Yogranov/ble-gate-opener/hardware/case/print/body-and-logo.3mf

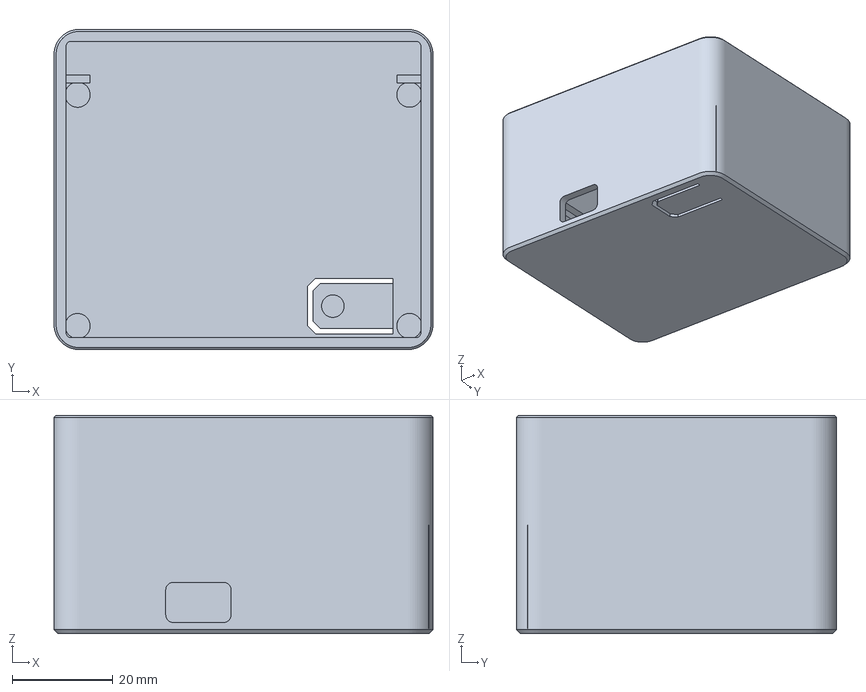
[picture p2: CAD file, 2026-11-06]
hardware/case/print/body-and-logo.3mf
75.4 x 63.7 x 43.4 mm
