Yogranov/ble-gate-opener/hardware/case/print/cover.3mf

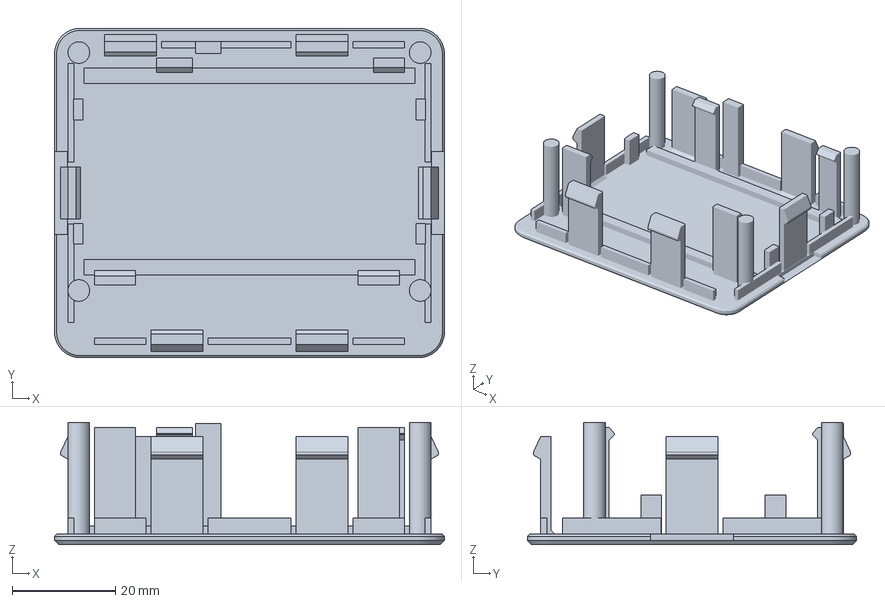
[picture p3: CAD file, 2026-11-06]
hardware/case/print/cover.3mf
75.4 x 63.7 x 23.6 mm
