Yogranov/ble-gate-opener/manual.html

Side 1 of 2. Print at actual size (100%), on both sides, flipping on the long edge. Cut on the four corner marks. Then fold the bottom half behind, twice, and the right half behind, once. The logo stays on the outside, and the sheet ends up 60 × 33 mm.

This bar must measure 50 mm, or the folded sheet will not fit the case:

YogiGate

# Technician manual

Fit a unit in a car, pair it with the gate's beacon, and test it.

## Set it up

1. Fit the unit. Stick the case in the glove box with Velcro. Any position works, but it must not slide or tumble.
2. Power it. Use a phone charger in a socket that turns off with the ignition, not a screen's USB port, and start the car. One long beep means no beacon is paired yet.
3. Start the hotspot. Triple-click the button on top of the case. You hear three short beeps. It does not start by itself.
4. Join it. In your phone's Wi-Fi settings, choose YogiGate-XXXX. The password is password. If the phone warns about no internet, stay connected.
5. Open the page. Go to http://192.168.4.1, and type the http:// too.
6. Pair the beacon. On the Beacon tab, either type its MAC, or tap Scan and then Use. At the bench, you can also hold the button for 3 s and hold the beacon against the unit. You hear short, short, long.
1. Test it, parked. On the Status tab, Signal shows a number and Live motion moves when you shake the unit. Close the glove box and tap Press the remote. You hear one short beep, and the gate must open from the parking spot.
2. Test it, driving. Start the car and wait: the gate must stay shut. Drive off: the gate opens within a few seconds, with no beep.

## The button

One clickPress the remote

Two clicksSet the set point here

Three clicksStart the hotspot

Hold 3 sPair a beacon held close

Hold 15 sFactory reset

Two clicks, then hold 6 sLearn the gate remote (RF units)

Factory reset erases the settings, beacon and logs, and puts the password back to password. With the unit on, hold the button past the two short beeps, until you hear five short and one long. One long beep means it is done, within a minute.

## Good to know

Replace the remote's battery every year, because the unit cannot tell when it dies. Advanced mode, at the bottom of the Settings tab, shows every setting, Reset to defaults, Factory reset and firmware upload. Change password is on the same tab. This manual is also on the page's Help tab.

Side 2 of 2. This is the back of the same sheet. It goes back inside the case folded, taped to the inside of the top, in the middle.

## What each sound means

No beep when the gate opens by itself. That is correct.

One short: pressed by hand

Two short: pairing, so hold the beacon close

Three short: hotspot starting

Short, short, long: saved

Two rattles: that did not work, so try again

One long at power-on: no beacon is paired yet

Three long: motion sensor failed

Five short, one long: factory reset, erasing

## If it goes wrong

No hotspotTriple-click, and listen for three short beeps.

Page will not openJoin by hand in Wi-Fi settings, and type http://.

Gate stays shutCheck the remote's battery and range, then the Signal on the Status tab.

Opens from the streetRaise the set point on the Settings tab.

Opens while parkedFix the unit so it cannot move, then rate that trip on the Logs tab.

Three long beepsCheck the sensor's four wires. Until fixed, the gate can open from the spot.

Remote's LED stays onIts two wires are swapped.

## Keep this sheet

Fold the bottom half behind, twice, and the right half behind, once, with the logo outside. Tape it to the inside of the case's top, in the middle, with its long side along the case's long side. Keep it off the button tab.
