Yogranov/ble-gate-opener/tools/yg_logs.py

#!/usr/bin/env python3
"""Fetch and analyse YogiGate logs. Log files stay in logs/, which git ignores.

    python tools/yg_logs.py fetch --port COM3          over USB
    python tools/yg_logs.py fetch --host 192.168.4.1   over the hotspot
    python tools/yg_logs.py summary logs/some.ndjson   one line per trip, then totals
    python tools/yg_logs.py replay logs/some.ndjson --trip 12 --set motion_accel_mg=60

Replay runs a trip through the current logic, starting from the settings the trip
really had, then changed by any --set. Build it first with: python test/host/run_tests.py
"""
import argparse
import base64
import json
import os
import statistics
import struct
import subprocess
import sys
import time
import urllib.request

ROOT = os.path.abspath(os.path.join(os.path.dirname(__file__), ".."))
ACCEL_LSB_PER_G = 16384.0
GYRO_LSB_PER_DPS = 131.0
SAMPLE_MS = 20
TICK_MS = 100
# What a boot record calls the settings that decide on a press, and what they are called.
BOOT_SETTINGS = {
    "set_point": "set_point_dbm", "press_ms": "press_ms", "moved_window_s": "moved_window_s", "gone_s": "gone_s",
    "still_s": "still_s", "fallback_dbm": "fallback_dbm", "motion_enabled": "motion_enabled",
    "motion_accel_mg": "motion_accel_mg", "motion_accel_ms": "motion_accel_ms", "motion_yaw_deg": "motion_yaw_deg",
    "motion_yaw_window_ms": "motion_yaw_window_ms",
}
# The esp_reset_reason_t values worth mentioning. See docs/log-format.md.
BAD_RESETS = {4: "panic", 5: "watchdog", 6: "watchdog", 7: "watchdog", 9: "brownout"}
BROWNOUT = 9


def default_output():
    os.makedirs(os.path.join(ROOT, "logs"), exist_ok=True)
    return os.path.join(ROOT, "logs", time.strftime("yogigate-%Y%m%d-%H%M%S.ndjson"))


def fetch_usb(port, captures, out_path):
    sys.path.insert(0, os.path.dirname(__file__))
    import yg_serial

    s = yg_serial.open_port(port)
    s.reset_input_buffer()
    s.write(("logs" if captures else "logs nocapture").encode() + b"\n")
    good = bad = 0
    data = bytearray()
    last = time.time()
    done = False
    with open(out_path, "w", encoding="utf-8") as out:
        begun = False
        while time.time() - last < 15 and not done:
            chunk = s.read(65536)
            if not chunk:
                continue
            last = time.time()
            data += chunk
            *lines, rest = data.split(b"\n")
            data = bytearray(rest)
            for raw in lines:
                line = raw.decode(errors="replace").strip()
                if line == "#BEGIN":
                    begun = True
                elif line == "#END":
                    done = True
                elif begun and line.startswith("{"):
                    try:
                        json.loads(line)
                        out.write(line + "\n")
                        good += 1
                    except ValueError:
                        bad += 1
    s.close()
    print(f"{good} records saved to {out_path}" + (f", {bad} damaged lines skipped" if bad else ""))
    if not done:
        print("WARNING: the unit stopped sending before the end of the logs. This file is not complete.")


def fetch_http(host, captures, out_path):
    url = f"http://{host}/api/logs/export" + ("" if captures else "?captures=0")
    with urllib.request.urlopen(url, timeout=120) as response, open(out_path, "wb") as out:
        total = 0
        while True:
            chunk = response.read(65536)
            if not chunk:
                break
            out.write(chunk)
            total += len(chunk)
    print(f"{total} bytes saved to {out_path}")


def read_records(path):
    with open(path, encoding="utf-8") as f:
        for line in f:
            line = line.strip()
            if line:
                try:
                    yield json.loads(line)
                except ValueError:
                    pass


def trace_samples(record):
    """Yields (time_ms, rssi or None, adverts, accel_mg, yaw_dps, flags)."""
    for i, s in enumerate(record["s"]):
        yield record["t"] + i * record["period"] * 1000, s[0] if s[1] else None, s[1], s[2], s[3], s[4]


def summarise(records):
    trips = {}
    ratings = {}

    def trip_of(number):
        return trips.setdefault(number, {
            "trip": number, "fw": "", "duration": 0, "heard": None, "motion": None, "press": None, "presses": 0,
            "parked": None, "peak": None, "heard_adverts": 0, "heard_seconds": 0, "temp": None, "errors": [], "env": None, "near_miss": 0,
            "reset": None, "zero": None,
        })

    for r in records:
        if "trip" not in r:
            continue
        t = trip_of(r["trip"])
        kind = r.get("k")
        t["duration"] = max(t["duration"], r["t"])
        if kind == "boot":
            t["fw"] = r["fw"]
            t["reset"] = r.get("reset")
        elif kind == "gyro_zero" and t["zero"] is None:
            t["zero"] = r
        elif kind == "first_heard" and t["heard"] is None:
            t["heard"] = r
        elif kind == "motion" and t["motion"] is None:
            t["motion"] = r
        elif kind == "press":
            t["presses"] += 1
            if t["press"] is None:
                t["press"] = r
        elif kind == "temp" and t["temp"] is None:
            t["temp"] = r["c"]
        elif kind == "error":
            t["errors"].append(r["code"])
        elif kind == "env":
            t["env"] = r
        elif kind == "rating":
            ratings[r["rated_trip"]] = r["rating"]
        elif kind == "trace":
            for at, rssi, adverts, _, _, flags in trace_samples(r):
                t["duration"] = max(t["duration"], at)
                # Longer periods cap their count and may only be heard for part of the time.
                if r["period"] == 1 and adverts:
                    t["heard_adverts"] += adverts
                    t["heard_seconds"] += 1
                if flags & 2:
                    t["near_miss"] += 1
                if rssi is None:
                    continue
                if t["peak"] is None or rssi > t["peak"][1]:
                    t["peak"] = (at, rssi)
    for r in records:
        # A second pass, because trace records can reach the log after a motion record.
        if r.get("k") == "trace":
            t = trips[r["trip"]]
            for at, rssi, *_ in trace_samples(r):
                if rssi is not None and (t["motion"] is None or at < t["motion"]["t"]):
                    t["parked"] = rssi if t["parked"] is None else max(t["parked"], rssi)
    for number, rating in ratings.items():
        trip_of(number)["rating"] = rating
    return trips


def restart_note(t, failed):
    """Why this trip's start was not a clean one. A start that dies before the radio is up
    uses a trip number and logs nothing, so only the gap and the next start's reset show it."""
    name = BAD_RESETS.get(t["reset"])
    if name is None:
        return ""
    return f"{name} after {failed} failed start{'' if failed == 1 else 's'}" if failed else name


def cmd_summary(args):
    records = list(read_records(args.file))
    trips = summarise(records)
    print(f"{'trip':>5} {'fw':>7} {'length':>7} {'parked':>7} {'moved':>7} {'press':>7} {'n':>2} {'reason':>8} "
          f"{'warn':>6} {'peak':>5} {'adv/s':>6} {'temp':>5} {'near':>4}  rating / errors")
    warnings, parked, peaks = [], [], []
    failed_total = failed_chains = 0
    previous = None
    for number in sorted(trips):
        t = trips[number]
        failed = number - previous - 1 if previous is not None and t["reset"] == BROWNOUT else 0
        previous = number
        failed_total += failed
        failed_chains += 1 if failed else 0
        seconds = t["duration"] / 1000
        press_at = f"{t['press']['t'] / 1000:.1f}" if t["press"] else "-"
        moved_at = f"{t['motion']['t'] / 1000:.1f}" if t["motion"] else "-"
        warn = "-"
        if t["press"] and t["peak"] and t["peak"][0] >= t["press"]["t"]:
            value = (t["peak"][0] - t["press"]["t"]) / 1000
            warnings.append(value)
            warn = f"{value:.1f}"
        if t["parked"] is not None:
            parked.append(t["parked"])
        if t["peak"]:
            peaks.append(t["peak"][1])
        guessed = t["zero"] is not None and t["zero"]["how"] == "time_up"
        note = " ".join(filter(None, [restart_note(t, failed), "gyro zero guessed" if guessed else "", t.get("rating"), ",".join(t["errors"])]))
        adverts = f"{t['heard_adverts'] / t['heard_seconds']:.1f}" if t["heard_seconds"] else "-"
        print(f"{number:>5} {t['fw']:>7} {seconds:>6.0f}s {t['parked'] if t['parked'] is not None else '-':>7} "
              f"{moved_at:>7} {press_at:>7} {t['presses']:>2} {t['press']['reason'] if t['press'] else '-':>8} "
              f"{warn:>6} {t['peak'][1] if t['peak'] else '-':>5} {adverts:>6} "
              f"{t['temp'] if t['temp'] is not None else '-':>5} {t['near_miss']:>4}  {note}")
    print()
    pressed_parked = sum(1 for t in trips.values() if t["press"] and t["press"]["reason"] == "auto" and t["motion"] is None)
    print(f"{len(trips)} trips, {sum(t['presses'] for t in trips.values())} presses, "
          f"{sum(1 for t in trips.values() if t['errors'])} with errors, "
          f"{pressed_parked} automatic presses with no motion logged.")
    if failed_total:
        print(f"{failed_total} failed start{'' if failed_total == 1 else 's'} before "
              f"{failed_chains} power-up{'' if failed_chains == 1 else 's'}. Time is lost to each, and the gate cannot open meanwhile.")
    if warnings:
        print(f"Warning time: median {statistics.median(warnings):.1f} s, range {min(warnings):.1f} to {max(warnings):.1f} s.")
    if parked:
        print(f"Strongest signal while parked: median {statistics.median(parked):.0f}, range {min(parked)} to {max(parked)} dBm.")
    if peaks:
        print(f"Peak signal: median {statistics.median(peaks):.0f}, range {min(peaks)} to {max(peaks)} dBm.")
    captures = sum(1 for r in records if r.get("k") == "cap_start")
    if captures:
        print(f"{captures} debug captures.")


def capture_events(records, trip):
    """Raw motion samples and adverts from one trip's debug captures, and the spans of
    time they cover. A capture cut short by a power cut still counts: samples are timed
    from its start record."""
    events = []
    windows = []
    start = None
    for r in records:
        if r.get("trip") != trip:
            continue
        kind = r.get("k")
        if kind == "cap_start":
            start = r
            windows.append([r["t"] - r["pre"] * SAMPLE_MS, r["t"]])
        elif kind == "cap_imu" and start is not None:
            data = base64.b64decode(r["b64"])
            for i in range(r["n"]):
                s = struct.unpack_from("<6h", data, i * 12)
                at = start["t"] + (r["first"] + i - start["pre"]) * SAMPLE_MS
                values = [v / ACCEL_LSB_PER_G for v in s[:3]] + [v / GYRO_LSB_PER_DPS for v in s[3:]]
                events.append((at, f"I,{at}," + ",".join(f"{v:.5f}" for v in values)))
                windows[-1][1] = max(windows[-1][1], at)
        elif kind == "cap_adv" and start is not None:
            data = base64.b64decode(r["b64"])
            for i in range(r["n"]):
                at, rssi = struct.unpack_from("<Ib", data, i * 5)
                events.append((at, f"A,{at},{rssi}"))
    return events, windows


def trace_events(records, trip):
    events = []
    for r in records:
        if r.get("trip") != trip:
            continue
        if r.get("k") == "motion":
            events.append((r["t"], f"M,{r['t']}"))
        elif r.get("k") == "trace":
            for at, rssi, *_ in trace_samples(r):
                if rssi is not None:
                    events.append((at, f"A,{at},{rssi}"))
    return events


def boot_settings(records, trip):
    """The settings the trip started with, as (key, value) pairs."""
    for r in records:
        if r.get("trip") == trip and r.get("k") == "boot":
            pairs = []
            for name, key in BOOT_SETTINGS.items():
                if name in r:
                    value = r[name]
                    pairs.append((key, int(value) if isinstance(value, bool) else value))
            return pairs
    return []


def saved_zero(records, trip):
    """The gyro zero the unit had saved when the trip started, as far as its record shows. A
    first steady start saved its own, and a trip that guessed had none it could use."""
    for r in records:
        if r.get("trip") == trip and r.get("k") == "gyro_zero":
            used_saved = r["how"] == "known" or (r["how"] == "steady" and not r["saved"])
            return (r["x"], r["y"], r["z"]) if used_saved else None
    return None


def setting_events(records, trip, overridden):
    """Settings changed during the trip, unless this replay is overriding them."""
    known = set(BOOT_SETTINGS.values()) - overridden
    return [(r["t"], f"set,{r['key']},{r['value']}") for r in records
            if r.get("trip") == trip and r.get("k") == "setting" and r["key"] in known]


def sensor_events(records, trip):
    events = []
    for r in records:
        if r.get("trip") == trip and r.get("k") == "error" and r["code"].startswith("sensor_") and r["code"] != "sensor_glitch":
            events.append((r["t"], f"{'R' if r['code'] == 'sensor_recovered' else 'F'},{r['t']}"))
    return events


def cmd_replay(args):
    exe = os.path.join(ROOT, "build-host", "replay" + (".exe" if os.name == "nt" else ""))
    if not os.path.exists(exe):
        sys.exit("Build the replay program first: python test/host/run_tests.py")
    records = list(read_records(args.file))
    overrides = [change.partition("=")[::2] for change in args.settings]
    captured, windows = capture_events(records, args.trip)
    # Raw data is better where there is any, but only the trace covers the rest.
    traced = [e for e in trace_events(records, args.trip) if not any(a <= e[0] <= b for a, b in windows)]
    events = captured + traced + sensor_events(records, args.trip)
    if not events:
        sys.exit(f"Trip {args.trip} has nothing to replay.")
    events += setting_events(records, args.trip, {key for key, _ in overrides})
    events.sort(key=lambda e: e[0])
    source = f"{len(windows)} raw captures and the trace" if windows else "the trace, with motion as logged"
    start_settings = boot_settings(records, args.trip)
    lines = [f"set,{key},{value}" for key, value in start_settings + overrides]
    zero = saved_zero(records, args.trip)
    if zero is not None:
        lines.append("zero," + ",".join(str(v) for v in zero))
    next_tick = events[0][0]
    for at, line in events:
        while next_tick <= at:
            lines.append(f"T,{next_tick}")
            next_tick += TICK_MS
        lines.append(line)
    for _ in range(600):
        lines.append(f"T,{next_tick}")
        next_tick += TICK_MS
    result = subprocess.run([exe], input="\n".join(lines) + "\n", capture_output=True, text=True)
    if result.returncode != 0:
        sys.exit(result.stderr.strip())
    print(f"Trip {args.trip}, from {source}.")
    print("Recorded:")
    for r in records:
        if r.get("trip") == args.trip and r.get("k") in ("press", "motion", "rearm"):
            print(f"  {r['k'].upper()},{r['t']},{r.get('reason') or r.get('cause')}")
    base = "the trip's settings" if start_settings else "default settings, as its boot record is gone"
    print("Replayed with " + ", then ".join([base] + args.settings) + ":")
    print("  " + (result.stdout.strip().replace("\n", "\n  ") or "nothing"))


def main():
    parser = argparse.ArgumentParser(description=__doc__, formatter_class=argparse.RawDescriptionHelpFormatter)
    sub = parser.add_subparsers(dest="command", required=True)
    fetch = sub.add_parser("fetch")
    fetch.add_argument("--port")
    fetch.add_argument("--host")
    fetch.add_argument("--out")
    fetch.add_argument("--no-captures", action="store_true")
    summary = sub.add_parser("summary")
    summary.add_argument("file")
    replay = sub.add_parser("replay")
    replay.add_argument("file")
    replay.add_argument("--trip", type=int, required=True)
    replay.add_argument("--set", dest="settings", action="append", default=[], metavar="KEY=VALUE")
    args = parser.parse_args()

    if args.command == "fetch":
        out = args.out or default_output()
        if args.port:
            fetch_usb(args.port, not args.no_captures, out)
        elif args.host:
            fetch_http(args.host, not args.no_captures, out)
        else:
            sys.exit("Give --port or --host.")
    elif args.command == "summary":
        cmd_summary(args)
    else:
        cmd_replay(args)


if __name__ == "__main__":
    main()
