Yogranov/ble-gate-opener/test/host/test_motion.c

#include <math.h>
#include <stdlib.h>

#include "yg_motion.h"
#include "yg_test.h"

#define DT_MS 20
#define PI    3.14159265f

/* Attitude maps the car frame (x forward, y left, z up) to the sensor frame. */
typedef struct { float m[3][3]; } mat3;

static mat3 identity(void) {
    mat3 r = { { { 1, 0, 0 }, { 0, 1, 0 }, { 0, 0, 1 } } };
    return r;
}

static mat3 mul(mat3 a, mat3 b) {
    mat3 r;
    for (int i = 0; i < 3; i++) {
        for (int j = 0; j < 3; j++) {
            r.m[i][j] = a.m[i][0] * b.m[0][j] + a.m[i][1] * b.m[1][j] + a.m[i][2] * b.m[2][j];
        }
    }
    return r;
}

static mat3 rot_x(float deg) {
    float c = cosf(deg * PI / 180), s = sinf(deg * PI / 180);
    mat3 r = { { { 1, 0, 0 }, { 0, c, -s }, { 0, s, c } } };
    return r;
}

static mat3 rot_y(float deg) {
    float c = cosf(deg * PI / 180), s = sinf(deg * PI / 180);
    mat3 r = { { { c, 0, s }, { 0, 1, 0 }, { -s, 0, c } } };
    return r;
}

static void apply(const mat3 *r, const float v[3], float out[3]) {
    for (int i = 0; i < 3; i++) {
        out[i] = r->m[i][0] * v[0] + r->m[i][1] * v[1] + r->m[i][2] * v[2];
    }
}

static const float BIAS[3] = { 10.0f, -7.0f, 4.0f };

typedef struct {
    yg_motion_t m;
    yg_settings_t s;
    mat3 attitude;
    uint32_t now;
    yg_motion_cause_t first_cause;
    uint32_t first_cause_at;
    bool any_near_miss;
    yg_motion_out_t out;

    /* What a real sensor adds, in its own axes. */
    float zero[3];                   /* deg/s: the gyro's zero moving after calibration. */
    float accel_offset[3];           /* g */
    float gyro_scale;                /* A fraction. */
    float shake_a, shake_g;          /* Engine shake at 23 Hz, in g and deg/s. */
    float random_a, random_g;        /* Band-limited shake: standard deviations. */
    float random_alpha, random_slow_alpha;
    float random_lp[6], random_slow[6];
    uint32_t tick;
} rig_t;

static float noise(float amp) {
    return amp * ((float)rand() / (float)RAND_MAX * 2.0f - 1.0f);
}

/* One sample: linear acceleration in g and rotation in deg/s, both in the car frame. */
static void step(rig_t *r, const float accel[3], const float gyro[3]) {
    float car_a[3] = { accel[0], accel[1], accel[2] + 1.0f };
    yg_imu_sample_t in;
    float a[3], g[3];
    apply(&r->attitude, car_a, a);
    apply(&r->attitude, gyro, g);
    float phase = 2 * PI * 23.0f * (float)(r->tick++) * 0.02f;
    const float shake_a[3] = { r->shake_a * sinf(phase), r->shake_a * cosf(phase), r->shake_a * sinf(phase + 1) };
    const float shake_g[3] = { r->shake_g * sinf(phase), r->shake_g * cosf(phase), r->shake_g * sinf(phase + 2) };
    float v[6];
    for (int i = 0; i < 3; i++) {
        v[i] = a[i] + r->accel_offset[i] + shake_a[i] + noise(0.002f);
        v[i + 3] = g[i] * (1.0f + r->gyro_scale) + BIAS[i] + r->zero[i] + shake_g[i] + noise(0.1f);
    }
    for (int i = 0; r->random_alpha > 0 && i < 6; i++) {
        float sd = i < 3 ? r->random_a : r->random_g;
        r->random_lp[i] += r->random_alpha * (noise(sd * sqrtf(3.0f * (2.0f - r->random_alpha) / r->random_alpha)) - r->random_lp[i]);
        r->random_slow[i] += r->random_slow_alpha * (r->random_lp[i] - r->random_slow[i]);
        v[i] += r->random_lp[i] - r->random_slow[i];
    }
    in.ax = v[0];
    in.ay = v[1];
    in.az = v[2];
    in.gx = v[3];
    in.gy = v[4];
    in.gz = v[5];
    yg_motion_update(&r->m, &r->s, r->now, &in, &r->out);
    if (r->out.cause != YG_MOTION_NONE && r->first_cause == YG_MOTION_NONE) {
        r->first_cause = r->out.cause;
        r->first_cause_at = r->now;
    }
    if (r->out.near_miss) r->any_near_miss = true;
    r->now += DT_MS;
}

static void still(rig_t *r, uint32_t ms) {
    const float zero[3] = { 0, 0, 0 };
    for (uint32_t t = 0; t < ms; t += DT_MS) step(r, zero, zero);
}

static void rig_init(rig_t *r, mat3 attitude) {
    memset(r, 0, sizeof(*r));
    yg_settings_defaults(&r->s);
    yg_motion_init(&r->m);
    r->attitude = attitude;
    r->now = 1000;
}

static void reset_seen(rig_t *r) {
    r->first_cause = YG_MOTION_NONE;
    r->any_near_miss = false;
}

static mat3 orientation(int i) {
    switch (i) {
    case 0: return identity();
    case 1: return mul(rot_x(35), rot_y(50));
    case 2: return mul(rot_x(170), rot_y(-20));
    default: return rot_y(90);   /* Standing on its side. */
    }
}
#define ORIENTATIONS 4

static void still_car_calibrates_fast_and_stays_quiet(void) {
    for (int o = 0; o < ORIENTATIONS; o++) {
        static rig_t r;
        rig_init(&r, orientation(o));
        still(&r, 2100);
        CHECK(r.out.calibrated);
        still(&r, 60000);
        CHECK_INT(r.first_cause, YG_MOTION_NONE);
    }
}

static void no_motion_is_reported_before_calibration(void) {
    static rig_t r;
    rig_init(&r, identity());
    const float a[3] = { 0.3f, 0, 0 };
    const float g[3] = { 0, 0, 40 };
    for (int i = 0; i < 20; i++) step(&r, a, g);
    CHECK(!r.out.calibrated);
    CHECK_INT(r.first_cause, YG_MOTION_NONE);
}

static void engine_shake_is_ignored_and_calibration_falls_back(void) {
    static rig_t r;
    rig_init(&r, orientation(1));
    uint32_t calibrated_at = 0;
    for (uint32_t t = 0; t < 60000; t += DT_MS) {
        float phase = 2 * PI * 23.0f * (float)t / 1000.0f;
        float a[3] = { 0.03f * sinf(phase), 0.03f * cosf(phase), 0.03f * sinf(phase + 1) };
        float g[3] = { 2.0f * sinf(phase), 2.0f * cosf(phase), 2.0f * sinf(phase + 2) };
        step(&r, a, g);
        if (r.out.calibrated && calibrated_at == 0) calibrated_at = t + DT_MS;
    }
    CHECK(calibrated_at > 0);
    CHECK(calibrated_at <= 10100);
    CHECK_INT(r.first_cause, YG_MOTION_NONE);
}

static void pulling_out_reports_acceleration_within_a_second(void) {
    for (int o = 0; o < ORIENTATIONS; o++) {
        static rig_t r;
        rig_init(&r, orientation(o));
        still(&r, 5000);
        uint32_t start = r.now;
        const float a[3] = { 0.1f, 0, 0 };
        const float g[3] = { 0, 0, 0 };
        for (int i = 0; i < 100; i++) step(&r, a, g);
        CHECK_INT(r.first_cause, YG_MOTION_ACCEL);
        CHECK(r.first_cause_at - start <= 1000);
    }
}

static void reversing_is_detected_too(void) {
    static rig_t r;
    rig_init(&r, orientation(2));
    still(&r, 5000);
    const float a[3] = { -0.08f, 0, 0 };
    const float g[3] = { 0, 0, 0 };
    for (int i = 0; i < 100; i++) step(&r, a, g);
    CHECK_INT(r.first_cause, YG_MOTION_ACCEL);
}

static void gentle_creep_below_threshold_is_not_acceleration(void) {
    static rig_t r;
    rig_init(&r, identity());
    still(&r, 5000);
    const float a[3] = { 0.03f, 0, 0 };
    const float g[3] = { 0, 0, 0 };
    for (int i = 0; i < 250; i++) step(&r, a, g);
    CHECK_INT(r.first_cause, YG_MOTION_NONE);
}

static void short_push_below_time_threshold_is_ignored(void) {
    static rig_t r;
    rig_init(&r, identity());
    still(&r, 5000);
    const float a[3] = { 0.1f, 0, 0 };
    const float g[3] = { 0, 0, 0 };
    for (int i = 0; i < 25; i++) step(&r, a, g);   /* 500 ms */
    still(&r, 5000);
    CHECK_INT(r.first_cause, YG_MOTION_NONE);
    CHECK(r.any_near_miss);
}

static void turning_reports_yaw_within_a_second(void) {
    for (int o = 0; o < ORIENTATIONS; o++) {
        for (int dir = -1; dir <= 1; dir += 2) {
            static rig_t r;
            rig_init(&r, orientation(o));
            still(&r, 5000);
            uint32_t start = r.now;
            const float a[3] = { 0, 0, 0 };
            const float g[3] = { 0, 0, 20.0f * (float)dir };
            for (int i = 0; i < 50; i++) step(&r, a, g);
            CHECK_INT(r.first_cause, YG_MOTION_YAW);
            CHECK(r.first_cause_at - start <= 1000);
        }
    }
}

static void slow_rotation_outside_the_window_is_not_a_turn(void) {
    static rig_t r;
    rig_init(&r, identity());
    still(&r, 5000);
    const float a[3] = { 0, 0, 0 };
    const float g[3] = { 0, 0, 1.0f };   /* 3 degrees per 3 s window. */
    for (int i = 0; i < 1000; i++) step(&r, a, g);
    CHECK_INT(r.first_cause, YG_MOTION_NONE);
}

static void door_slam_is_a_near_miss_not_motion(void) {
    for (int o = 0; o < ORIENTATIONS; o++) {
        static rig_t r;
        rig_init(&r, orientation(o));
        still(&r, 5000);
        /* A hard shove that dies away in 0.2 s, then the body bounces at 1.5 Hz. */
        for (uint32_t t = 0; t < 200; t += DT_MS) {
            float k = expf(-(float)t / 50.0f);
            float a[3] = { 0.1f * k, 0.3f * k, 0.3f * k };
            float g[3] = { 5.0f * k, 5.0f * k, 2.0f * k };
            step(&r, a, g);
        }
        for (uint32_t t = 0; t < 2000; t += DT_MS) {
            float k = expf(-(float)t / 600.0f) * sinf(2 * PI * 1.5f * (float)t / 1000.0f);
            float a[3] = { 0, 0.015f * k, 0.03f * k };
            float g[3] = { 1.0f * k, 0, 0 };
            step(&r, a, g);
        }
        still(&r, 3000);
        CHECK_INT(r.first_cause, YG_MOTION_NONE);
        CHECK(r.any_near_miss);
    }
}

/* Rolls or pitches the sensor by `deg` over `ms` around a horizontal car axis. */
static void tilt(rig_t *r, float deg, uint32_t ms, int axis) {
    float rate = deg / ((float)ms / 1000.0f);
    float done = 0;
    mat3 base = r->attitude;
    for (uint32_t t = 0; t < ms; t += DT_MS) {
        done += rate * DT_MS / 1000.0f;
        /* Gravity seen by the sensor turns as it rotates; the gyro reads the rate. */
        mat3 turn = axis == 0 ? rot_x(-done) : rot_y(-done);
        r->attitude = mul(base, turn);
        const float a[3] = { 0, 0, 0 };
        const float g[3] = { axis == 0 ? rate : 0, axis == 1 ? rate : 0, 0 };
        step(r, a, g);
    }
}

static void passenger_getting_in_is_ignored(void) {
    for (int o = 0; o < ORIENTATIONS; o++) {
        for (int axis = 0; axis < 2; axis++) {
            static rig_t r;
            rig_init(&r, orientation(o));
            still(&r, 5000);
            tilt(&r, 1.5f, 500, axis);
            still(&r, 30000);
            CHECK_INT(r.first_cause, YG_MOTION_NONE);
        }
    }
}

static void opening_the_glove_box_is_ignored(void) {
    for (int o = 0; o < ORIENTATIONS; o++) {
        for (int axis = 0; axis < 2; axis++) {
            static rig_t r;
            rig_init(&r, orientation(o));
            still(&r, 5000);
            tilt(&r, 45.0f, 1000, axis);
            still(&r, 20000);
            tilt(&r, -45.0f, 800, axis);
            still(&r, 20000);
            CHECK_INT(r.first_cause, YG_MOTION_NONE);
        }
    }
}

static void shove(rig_t *r, float g) {
    for (uint32_t t = 0; t < 200; t += DT_MS) {
        float k = expf(-(float)t / 50.0f);
        float a[3] = { 0, g * k, 0 };
        const float rot[3] = { 0, 0, 0 };
        step(r, a, rot);
    }
}

static void lean_then_door_shut_is_not_motion(void) {
    /* Someone sits down and the car leans, then a door shuts just after. */
    static const float LEANS[] = { 1.5f, 2.0f, 2.2f, 2.6f, 3.5f, 5.0f };
    static const uint32_t GAPS[] = { 500, 1000, 2000 };
    for (int o = 0; o < ORIENTATIONS; o++) {
        for (size_t l = 0; l < sizeof(LEANS) / sizeof(LEANS[0]); l++) {
            for (size_t g = 0; g < sizeof(GAPS) / sizeof(GAPS[0]); g++) {
                static rig_t r;
                rig_init(&r, orientation(o));
                still(&r, 5000);
                tilt(&r, LEANS[l], 500, o % 2);
                still(&r, GAPS[g]);
                shove(&r, 0.15f);
                still(&r, 5000);
                CHECK_INT(r.first_cause, YG_MOTION_NONE);
            }
        }
    }
}

static void slow_glove_box_is_ignored(void) {
    /* Below the rate that counts as tilting. */
    static const uint32_t TIMES[] = { 6000, 14000, 30000 };
    for (int o = 0; o < ORIENTATIONS; o++) {
        for (size_t i = 0; i < sizeof(TIMES) / sizeof(TIMES[0]); i++) {
            for (int axis = 0; axis < 2; axis++) {
                static rig_t r;
                rig_init(&r, orientation(o));
                still(&r, 5000);
                tilt(&r, 42.0f, TIMES[i], axis);
                still(&r, 10000);
                tilt(&r, -42.0f, TIMES[i], axis);
                still(&r, 10000);
                CHECK_INT(r.first_cause, YG_MOTION_NONE);
            }
        }
    }
}

static void motion_ends_soon_after_the_car_stops(void) {
    for (int o = 0; o < ORIENTATIONS; o++) {
        static rig_t r;
        rig_init(&r, orientation(o));
        still(&r, 5000);
        const float a[3] = { -0.2f, 0, 0 };
        const float g[3] = { 0, 0, 0 };
        for (int i = 0; i < 200; i++) step(&r, a, g);
        CHECK_INT(r.first_cause, YG_MOTION_ACCEL);
        still(&r, 1000);
        reset_seen(&r);
        still(&r, 20000);
        CHECK_INT(r.first_cause, YG_MOTION_NONE);
    }
}

static void booting_in_a_steady_bend_heals_once_parked(void) {
    /* Calibrating during a steady turn takes the turn for sensor bias. */
    static rig_t r;
    rig_init(&r, orientation(1));
    const float a[3] = { 0, 0, 0 };
    const float g[3] = { 0, 0, 6.0f };
    for (int i = 0; i < 250; i++) step(&r, a, g);
    CHECK(r.out.calibrated);
    still(&r, 35000);
    reset_seen(&r);
    still(&r, 30000);
    CHECK_INT(r.first_cause, YG_MOTION_NONE);
    const float turn[3] = { 0, 0, 25.0f };
    for (int i = 0; i < 75; i++) step(&r, a, turn);
    CHECK_INT(r.first_cause, YG_MOTION_YAW);
}

static void slow_sensor_drift_is_followed(void) {
    /* The gyro's zero moves as the car warms up. */
    for (int o = 0; o < ORIENTATIONS; o++) {
        static rig_t r;
        rig_init(&r, orientation(o));
        still(&r, 5000);
        const float a[3] = { 0, 0, 0 };
        for (uint32_t t = 0; t < 300000; t += DT_MS) {
            float d = 3.0f * (float)t / 300000.0f;
            const float g[3] = { d, -d, d / 2.0f };
            step(&r, a, g);
        }
        CHECK_INT(r.first_cause, YG_MOTION_NONE);
    }
}

static void a_small_shift_of_the_gyro_zero_is_ignored(void) {
    for (int o = 0; o < ORIENTATIONS; o++) {
        static rig_t r;
        rig_init(&r, orientation(o));
        still(&r, 5000);
        const float a[3] = { 0, 0, 0 };
        const float g[3] = { 0.8f, 0, 0 };
        for (int i = 0; i < 3000; i++) step(&r, a, g);
        CHECK_INT(r.first_cause, YG_MOTION_NONE);
    }
}

static void drift_is_followed_even_with_the_engine_shaking(void) {
    /* The shake leaves no quiet second to start over from. */
    for (int o = 0; o < ORIENTATIONS; o++) {
        static rig_t r;
        rig_init(&r, orientation(o));
        still(&r, 5000);
        for (uint32_t t = 0; t < 300000; t += DT_MS) {
            float phase = 2 * PI * 23.0f * (float)t / 1000.0f;
            float d = 3.0f * (float)t / 300000.0f;
            float a[3] = { 0.03f * sinf(phase), 0.03f * cosf(phase), 0.03f * sinf(phase + 1) };
            float g[3] = { d + 2.0f * sinf(phase), -d + 2.0f * cosf(phase), 2.0f * sinf(phase + 2) };
            step(&r, a, g);
        }
        CHECK_INT(r.first_cause, YG_MOTION_NONE);
    }
}

static void engine_on(rig_t *r) {
    r->shake_a = 0.03f;
    r->shake_g = 2.0f;
}

/* The gyro's zero moves, by an amount given along the car's axes. */
static void zero_moves(rig_t *r, float x, float y, float z) {
    const float car[3] = { x, y, z };
    apply(&r->attitude, car, r->zero);
}

static void a_gyro_zero_error_cannot_fake_motion(void) {
    /* Gravity follows the gyro, so a wrong zero could otherwise look like a lean. */
    static const float ERRORS[] = { 0.3f, 0.6f, 0.9f };
    for (int shake = 0; shake < 2; shake++) {
        for (int o = 0; o < ORIENTATIONS; o++) {
            for (size_t e = 0; e < sizeof(ERRORS) / sizeof(ERRORS[0]); e++) {
                static rig_t r;
                rig_init(&r, orientation(o));
                still(&r, 5000);
                if (shake) engine_on(&r);
                zero_moves(&r, ERRORS[e], 0, 0);
                still(&r, 120000);
                CHECK_INT(r.first_cause, YG_MOTION_NONE);
            }
        }
    }
}

static void a_big_gyro_zero_error_is_gone_after_a_rest(void) {
    /* The zero does not really jump like this, but nothing should depend on that. */
    static const float ERRORS[] = { 1.5f, 2.5f };
    for (int shake = 0; shake < 2; shake++) {
        for (size_t e = 0; e < sizeof(ERRORS) / sizeof(ERRORS[0]); e++) {
            static rig_t r;
            rig_init(&r, orientation(1));
            still(&r, 5000);
            if (shake) engine_on(&r);
            zero_moves(&r, ERRORS[e], 0, 0);
            still(&r, 35000);
            reset_seen(&r);
            still(&r, 60000);
            CHECK_INT(r.first_cause, YG_MOTION_NONE);
        }
    }
}

static void a_small_gyro_zero_error_fades_without_waiting_for_a_rest(void) {
    /* Left alone it would stand as a false lean, and hide a gentle pull-out the other way. */
    static rig_t r;
    rig_init(&r, orientation(1));
    still(&r, 5000);
    zero_moves(&r, 0.8f, 0, 0);
    still(&r, 25000);
    CHECK(r.out.horizontal_mg < 10.0f);
}

static void a_long_rest_repairs_the_gyro_with_the_engine_running(void) {
    /* Around the vertical gravity cannot show an error, so only a long rest can. */
    for (int o = 0; o < ORIENTATIONS; o++) {
        static rig_t r;
        rig_init(&r, orientation(o));
        still(&r, 5000);
        engine_on(&r);
        zero_moves(&r, 0, 0, 7.0f);
        still(&r, 35000);
        reset_seen(&r);
        still(&r, 60000);
        CHECK_INT(r.first_cause, YG_MOTION_NONE);
    }
}

static void a_long_rest_works_while_the_zero_drifts(void) {
    /* A rest that needed the gyro to hold still for 30 s might never come in a warming car. */
    static rig_t r;
    rig_init(&r, orientation(1));
    still(&r, 5000);
    for (uint32_t t = 0; t < 100000; t += DT_MS) {
        if (t == 40000) reset_seen(&r);
        zero_moves(&r, 0, 0, 7.0f + 0.03f * (float)t / 1000.0f);
        still(&r, DT_MS);
    }
    CHECK_INT(r.first_cause, YG_MOTION_NONE);
}

static bool close_to(float a, float b, float within) {
    return fabsf(a - b) <= within;
}

static bool zero_is(const float zero[3], const float expected[3], float within) {
    for (int i = 0; i < 3; i++) {
        if (!close_to(zero[i], expected[i], within)) return false;
    }
    return true;
}

/* Driving with no two seconds alike, so calibration can only end by running out of time. */
static void rolling(rig_t *r, uint32_t ms) {
    for (uint32_t t = 0; t < ms; t += DT_MS) {
        float phase = 2 * PI * (float)t / 7000.0f;
        const float a[3] = { 0.1f * sinf(phase), 0, 0 };
        const float g[3] = { 0, 0, 10.0f + 4.0f * sinf(phase) };
        step(r, a, g);
    }
}

static void a_start_on_a_moving_car_takes_the_known_gyro_zero(void) {
    for (int o = 0; o < ORIENTATIONS; o++) {
        static rig_t r;
        rig_init(&r, orientation(o));
        yg_motion_set_known_zero(&r.m, BIAS);
        rolling(&r, 22000);
        CHECK(r.out.calibrated);
        CHECK(zero_is(r.m.bias, BIAS, 0.6f));
    }
}

static void parked_after_a_moving_start_stays_quiet_with_a_known_zero(void) {
    /* From a real drive: the unit started as the car pulled out, took a zero about 6 deg/s off
     * from it, and then reported motion for as long as it sat still. */
    for (int o = 0; o < ORIENTATIONS; o++) {
        static rig_t r;
        rig_init(&r, orientation(o));
        yg_motion_set_known_zero(&r.m, BIAS);
        rolling(&r, 25000);
        still(&r, 5000);
        reset_seen(&r);
        still(&r, 20000);
        CHECK_INT(r.first_cause, YG_MOTION_NONE);
    }
}

static void a_moving_start_reports_the_known_zero_without_saving_it(void) {
    static rig_t r;
    rig_init(&r, identity());
    yg_motion_set_known_zero(&r.m, BIAS);
    rolling(&r, 22000);
    yg_zero_event_t ev = { 0 };
    CHECK(yg_motion_take_zero_event(&r.m, &ev));
    CHECK_INT(ev.source, YG_ZERO_KNOWN);
    CHECK(!ev.keep);
    CHECK(zero_is(ev.zero, BIAS, 0.01f));
}

static void a_moving_start_with_nothing_known_is_not_worth_keeping(void) {
    static rig_t r;
    rig_init(&r, identity());
    rolling(&r, 22000);
    CHECK(r.out.calibrated);
    yg_zero_event_t ev = { 0 };
    CHECK(yg_motion_take_zero_event(&r.m, &ev));
    CHECK_INT(ev.source, YG_ZERO_TIME_UP);
    CHECK(!ev.keep);
}

static void a_rest_after_a_moving_start_is_kept(void) {
    static rig_t r;
    rig_init(&r, identity());
    rolling(&r, 22000);
    yg_zero_event_t ev = { 0 };
    CHECK(yg_motion_take_zero_event(&r.m, &ev));
    still(&r, 35000);
    CHECK(yg_motion_take_zero_event(&r.m, &ev));
    CHECK_INT(ev.source, YG_ZERO_REST);
    CHECK(ev.keep);
    CHECK(zero_is(ev.zero, BIAS, 0.2f));
}

static void the_first_steady_start_is_kept_and_reported_once(void) {
    static rig_t r;
    rig_init(&r, identity());
    still(&r, 2100);
    yg_zero_event_t ev = { 0 };
    CHECK(yg_motion_take_zero_event(&r.m, &ev));
    CHECK_INT(ev.source, YG_ZERO_STEADY);
    CHECK(ev.keep);
    CHECK(zero_is(ev.zero, BIAS, 0.2f));
    CHECK(!yg_motion_take_zero_event(&r.m, &ev));
}

static void a_steady_start_measures_the_zero_and_leaves_the_known_one_saved(void) {
    /* A small difference may be noise, so this one waits for a long rest to decide. */
    static rig_t r;
    rig_init(&r, identity());
    const float known[3] = { BIAS[0] + 0.8f, BIAS[1] - 0.8f, BIAS[2] };
    yg_motion_set_known_zero(&r.m, known);
    still(&r, 2100);
    CHECK(zero_is(r.m.bias, BIAS, 0.2f));
    yg_zero_event_t ev = { 0 };
    CHECK(yg_motion_take_zero_event(&r.m, &ev));
    CHECK_INT(ev.source, YG_ZERO_STEADY);
    CHECK(!ev.keep);
}

static void a_steady_bend_does_not_replace_a_saved_zero(void) {
    /* Two seconds can agree in a steady bend, but that only hides turning around the vertical. */
    for (int o = 0; o < ORIENTATIONS; o++) {
        static rig_t r;
        rig_init(&r, orientation(o));
        yg_motion_set_known_zero(&r.m, BIAS);
        const float a[3] = { 0, 0, 0 };
        const float g[3] = { 0, 0, 6.0f };
        for (int i = 0; i < 150; i++) step(&r, a, g);
        CHECK(r.out.calibrated);
        yg_zero_event_t ev = { 0 };
        CHECK(yg_motion_take_zero_event(&r.m, &ev));
        CHECK_INT(ev.source, YG_ZERO_STEADY);
        CHECK(!ev.keep);
    }
}

static void a_steady_start_replaces_a_saved_zero_that_is_off_on_a_level_axis(void) {
    /* A sensor swapped for another. A bend cannot look like this, so it can be believed. */
    static rig_t r;
    rig_init(&r, identity());
    const float known[3] = { BIAS[0] + 5.0f, BIAS[1], BIAS[2] };
    yg_motion_set_known_zero(&r.m, known);
    still(&r, 2100);
    yg_zero_event_t ev = { 0 };
    CHECK(yg_motion_take_zero_event(&r.m, &ev));
    CHECK_INT(ev.source, YG_ZERO_STEADY);
    CHECK(ev.keep);
    CHECK(zero_is(ev.zero, BIAS, 0.2f));
}

/* Someone moving about in a parked car, so that no two seconds agree, with nothing turning overall. */
static void fidgeting(rig_t *r, uint32_t ms) {
    for (uint32_t t = 0; t < ms; t += DT_MS) {
        float phase = 2 * PI * (float)t / 5000.0f;
        const float a[3] = { 0.02f * sinf(phase), 0.02f * cosf(phase), 0 };
        const float g[3] = { 1.5f * sinf(phase), 0, 0 };
        step(r, a, g);
    }
}

static void a_saved_zero_that_the_start_disagrees_with_is_not_used(void) {
    /* Before this check, a parked car with a wrong saved zero reported motion until its first rest. */
    static const float OFF[] = { 3.5f, 6.0f, 15.0f };
    for (size_t i = 0; i < sizeof(OFF) / sizeof(OFF[0]); i++) {
        for (int axis = 0; axis < 2; axis++) {
            static rig_t r;
            rig_init(&r, identity());
            float known[3] = { BIAS[0], BIAS[1], BIAS[2] };
            known[axis] += OFF[i];
            yg_motion_set_known_zero(&r.m, known);
            fidgeting(&r, 22000);
            yg_zero_event_t ev = { 0 };
            CHECK(yg_motion_take_zero_event(&r.m, &ev));
            CHECK_INT(ev.source, YG_ZERO_TIME_UP);
            CHECK(!ev.keep);
            reset_seen(&r);
            still(&r, 25000);
            CHECK_INT(r.first_cause, YG_MOTION_NONE);
        }
    }
}

static void a_pull_out_is_still_seen_after_a_wrong_saved_zero(void) {
    /* A level error this big would hold the tilt check on, and hide the pull-out. */
    static rig_t r;
    rig_init(&r, identity());
    const float known[3] = { BIAS[0] + 10.0f, BIAS[1], BIAS[2] };
    yg_motion_set_known_zero(&r.m, known);
    fidgeting(&r, 22000);
    still(&r, 5000);
    reset_seen(&r);
    const float pull[3] = { 0.12f, 0, 0 };
    const float none[3] = { 0, 0, 0 };
    for (int i = 0; i < 150; i++) step(&r, pull, none);
    CHECK(r.first_cause != YG_MOTION_NONE);
}

static void an_impossible_saved_zero_is_ignored(void) {
    const float BAD[][3] = { { NAN, 0, 0 }, { 0, INFINITY, 0 }, { 0, 0, 100.0f } };
    for (size_t i = 0; i < sizeof(BAD) / sizeof(BAD[0]); i++) {
        static rig_t r;
        rig_init(&r, identity());
        yg_motion_set_known_zero(&r.m, BAD[i]);
        rolling(&r, 22000);
        CHECK(r.out.calibrated);
        yg_zero_event_t ev = { 0 };
        CHECK(yg_motion_take_zero_event(&r.m, &ev));
        CHECK_INT(ev.source, YG_ZERO_TIME_UP);
    }
}

static void a_saved_zero_that_is_not_a_number_does_not_stay_for_ever(void) {
    /* Every comparison with a NaN is false, so it would never look as if it had moved. */
    static rig_t r;
    rig_init(&r, identity());
    const float bad[3] = { NAN, 0, 0 };
    yg_motion_set_known_zero(&r.m, bad);
    still(&r, 2100);
    yg_zero_event_t ev = { 0 };
    CHECK(yg_motion_take_zero_event(&r.m, &ev));
    CHECK(ev.keep);
    CHECK(zero_is(ev.zero, BIAS, 0.2f));
}

static void an_impossible_zero_is_never_saved(void) {
    /* The datasheet allows 20 deg/s, so this is a sensor gone wrong. */
    static rig_t r;
    rig_init(&r, identity());
    zero_moves(&r, 50.0f, 0, 0);
    still(&r, 2100);
    yg_zero_event_t ev = { 0 };
    CHECK(yg_motion_take_zero_event(&r.m, &ev));
    CHECK_INT(ev.source, YG_ZERO_STEADY);
    CHECK(!ev.keep);
    still(&r, 35000);
    CHECK(!yg_motion_take_zero_event(&r.m, &ev));
}

static void a_rest_saves_only_a_zero_that_moved_by_half_a_degree(void) {
    static const struct { float moved; bool saved; } CASES[] = { { 0.3f, false }, { 0.7f, true } };
    for (size_t i = 0; i < sizeof(CASES) / sizeof(CASES[0]); i++) {
        static rig_t r;
        rig_init(&r, identity());
        yg_motion_set_known_zero(&r.m, BIAS);
        still(&r, 2100);
        yg_zero_event_t ev = { 0 };
        CHECK(yg_motion_take_zero_event(&r.m, &ev));
        zero_moves(&r, CASES[i].moved, 0, 0);
        still(&r, 35000);
        CHECK_INT(yg_motion_take_zero_event(&r.m, &ev), CASES[i].saved);
    }
}

static void a_saved_zero_is_not_saved_again_at_the_next_rest(void) {
    static rig_t r;
    rig_init(&r, identity());
    yg_motion_set_known_zero(&r.m, BIAS);
    still(&r, 2100);
    yg_zero_event_t ev = { 0 };
    CHECK(yg_motion_take_zero_event(&r.m, &ev));
    zero_moves(&r, 2.0f, 0, 0);
    still(&r, 35000);
    CHECK(yg_motion_take_zero_event(&r.m, &ev));
    CHECK(ev.keep);
    still(&r, 35000);
    CHECK(!yg_motion_take_zero_event(&r.m, &ev));
}

static void a_long_rest_keeps_a_zero_that_has_moved(void) {
    static rig_t r;
    rig_init(&r, identity());
    yg_motion_set_known_zero(&r.m, BIAS);
    still(&r, 2100);
    yg_zero_event_t ev = { 0 };
    CHECK(yg_motion_take_zero_event(&r.m, &ev));
    zero_moves(&r, 2.0f, 0, 0);
    still(&r, 35000);
    CHECK(yg_motion_take_zero_event(&r.m, &ev));
    CHECK_INT(ev.source, YG_ZERO_REST);
    CHECK(ev.keep);
    const float moved[3] = { BIAS[0] + 2.0f, BIAS[1], BIAS[2] };
    CHECK(zero_is(ev.zero, moved, 0.2f));
}

static void a_long_rest_with_the_same_zero_saves_nothing(void) {
    /* A rest comes every 30 s in a parked car, and each save wears the flash a little. */
    static rig_t r;
    rig_init(&r, identity());
    yg_motion_set_known_zero(&r.m, BIAS);
    still(&r, 2100);
    yg_zero_event_t ev = { 0 };
    CHECK(yg_motion_take_zero_event(&r.m, &ev));
    still(&r, 100000);
    CHECK(!yg_motion_take_zero_event(&r.m, &ev));
}

static void warming_up_stays_quiet(void) {
    /* deg/s per second. Even at the worst the datasheet allows, a car warms too slowly to
     * pass 0.02. The zero can move around the vertical too, which gravity cannot show. */
    static const float RAMPS[] = { 0.01f, 0.02f, 0.04f, 0.06f };
    for (int shake = 0; shake < 2; shake++) {
        for (size_t i = 0; i < sizeof(RAMPS) / sizeof(RAMPS[0]); i++) {
            static rig_t r;
            rig_init(&r, orientation(1));
            still(&r, 5000);
            if (shake) engine_on(&r);
            for (uint32_t t = 0; t < 180000; t += DT_MS) {
                float d = RAMPS[i] * (float)t / 1000.0f;
                d = d > 6.0f ? 6.0f : d;
                zero_moves(&r, d / 2, -d / 4, d);
                still(&r, DT_MS);
            }
            CHECK_INT(r.first_cause, YG_MOTION_NONE);
        }
    }
}

static void start_shaking(rig_t *r, float a, float g, float hz, float low_hz, unsigned seed) {
    srand(seed);
    rig_init(r, orientation(1));
    still(r, 5000);
    float w = 2 * PI * hz * 0.02f;
    float slow = 2 * PI * low_hz * 0.02f;
    r->random_alpha = w / (1 + w);
    r->random_slow_alpha = slow / (1 + slow);
    r->random_a = a;
    r->random_g = g;
}

static void random_shake_while_parked_stays_quiet(void) {
    /* A body rocks around where it rests, so the slower shake has no very slow part. Still
     * seconds in a real car showed a gyro shake of about 0.2 deg/s, 0.3 at the 90th percentile
     * and under 1 at the 99th. Each seed is fixed, so that other tests' numbers cannot matter. */
    static const struct { float a, g, hz, low_hz; } SHAKES[] = {
        { 0.002f, 0.5f, 10, 0 }, { 0.005f, 1.0f, 10, 0 }, { 0.005f, 1.5f, 10, 0 },
        { 0.01f, 1.0f, 3, 0.3f }, { 0.01f, 2.0f, 3, 0.3f },
    };
    for (size_t i = 0; i < sizeof(SHAKES) / sizeof(SHAKES[0]); i++) {
        static rig_t r;
        start_shaking(&r, SHAKES[i].a, SHAKES[i].g, SHAKES[i].hz, SHAKES[i].low_hz, (unsigned)i + 1);
        still(&r, 180000);
        CHECK_INT(r.first_cause, YG_MOTION_NONE);
    }
}

static int false_motion_in_50_runs(float g) {
    int fired = 0;
    for (unsigned seed = 1; seed <= 50; seed++) {
        static rig_t r;
        start_shaking(&r, 0.01f, g, 10, 0, seed);
        still(&r, 180000);
        if (r.first_cause != YG_MOTION_NONE) fired++;
    }
    return fired;
}

static void heavier_shake_fires_no_more_often_than_measured(void) {
    /* A known weakness, in the spec's section 6: the gyro's noise slowly turns gravity away.
     * Well above a real car's shake, so it stays, but it must not get worse. The ceilings
     * are about 1.5 times the rates measured over 200 seeds, 12% and 33%. */
    CHECK(false_motion_in_50_runs(2.0f) <= 10);
    CHECK(false_motion_in_50_runs(3.0f) <= 25);
}

static void a_pull_out_is_seen_through_a_real_cars_shake(void) {
    /* Far above this, from about 3 deg/s, the shake holds the tilt check on and the
     * acceleration check goes deaf, which is the other half of the weakness in section 6. */
    static const float SHAKES[] = { 0.3f, 1.0f, 1.5f };
    for (size_t i = 0; i < sizeof(SHAKES) / sizeof(SHAKES[0]); i++) {
        for (unsigned seed = 1; seed <= 20; seed++) {
            static rig_t r;
            start_shaking(&r, 0.005f, SHAKES[i], 10, 0, seed);
            still(&r, 10000);
            reset_seen(&r);
            const float pull[3] = { 0.12f, 0, 0 };
            const float none[3] = { 0, 0, 0 };
            for (int t = 0; t < 150; t++) step(&r, pull, none);
            CHECK(r.first_cause != YG_MOTION_NONE);
        }
    }
}

static void a_passenger_gets_in_with_the_engine_on_from_the_start(void) {
    /* No quiet second, so calibration comes from an average around the 10 s deadline. */
    static const float LEANS[] = { 1.0f, 1.5f, 2.0f, 3.0f };
    static const uint32_t TIMES[] = { 4000, 8200, 9000, 9400, 11000, 12500 };
    for (size_t l = 0; l < sizeof(LEANS) / sizeof(LEANS[0]); l++) {
        for (size_t i = 0; i < sizeof(TIMES) / sizeof(TIMES[0]); i++) {
            static rig_t r;
            rig_init(&r, orientation(1));
            engine_on(&r);
            still(&r, TIMES[i]);
            tilt(&r, LEANS[l], 500, 0);
            still(&r, 60000 - TIMES[i]);
            CHECK_INT(r.first_cause, YG_MOTION_NONE);
        }
    }
}

static void a_lean_too_slow_for_the_gyro_is_ignored(void) {
    static const struct { float deg, rate; } LEANS[] = {
        { 3, 0.5f }, { 5, 0.5f }, { 3, 0.7f }, { 5, 0.7f }, { 3, 0.9f }, { 4, 0.9f }, { 6, 0.9f }, { 6, 1.1f }, { 6, 2.0f },
    };
    for (int shake = 0; shake < 2; shake++) {
        for (size_t i = 0; i < sizeof(LEANS) / sizeof(LEANS[0]); i++) {
            static rig_t r;
            rig_init(&r, orientation(1));
            still(&r, 5000);
            if (shake) engine_on(&r);
            tilt(&r, LEANS[i].deg, (uint32_t)(LEANS[i].deg / LEANS[i].rate * 1000.0f), 0);
            still(&r, 15000);
            CHECK_INT(r.first_cause, YG_MOTION_NONE);
        }
    }
}

static void a_glove_box_with_real_sensor_errors_is_ignored(void) {
    /* Offsets and scale errors mean that gravity and the accelerometer disagree after turning. */
    static const struct { float offset, scale; } ERRORS[] = { { 0.05f, 0 }, { 0.10f, 0 }, { 0, 0.03f }, { 0.05f, 0.03f } };
    static const uint32_t TIMES[] = { 1000, 6000, 14000, 30000 };
    for (size_t e = 0; e < sizeof(ERRORS) / sizeof(ERRORS[0]); e++) {
        for (size_t i = 0; i < sizeof(TIMES) / sizeof(TIMES[0]); i++) {
            /* A known limit: twice the datasheet's offset, on a glove box opened just too
             * slowly to count as tilting. */
            if (ERRORS[e].offset > 0.06f && TIMES[i] == 6000) continue;
            for (int o = 0; o < ORIENTATIONS; o++) {
                for (int axis = 0; axis < 2; axis++) {
                    static rig_t r;
                    rig_init(&r, orientation(o));
                    r.accel_offset[0] = ERRORS[e].offset;
                    r.accel_offset[1] = -ERRORS[e].offset;
                    r.accel_offset[2] = ERRORS[e].offset;
                    r.gyro_scale = ERRORS[e].scale;
                    still(&r, 5000);
                    tilt(&r, 42.0f, TIMES[i], axis);
                    still(&r, 10000);
                    tilt(&r, -42.0f, TIMES[i], axis);
                    still(&r, 10000);
                    CHECK_INT(r.first_cause, YG_MOTION_NONE);
                }
            }
        }
    }
}

static void the_unit_moving_while_samples_were_lost_is_ignored(void) {
    static const struct { float deg; uint32_t gap; } GAPS[] = {
        { 1.5f, 1000 }, { 2, 1000 }, { 2.5f, 1000 }, { 3, 2000 }, { 5, 4000 }, { 20, 4000 }, { 45, 4000 },
    };
    for (size_t i = 0; i < sizeof(GAPS) / sizeof(GAPS[0]); i++) {
        static rig_t r;
        rig_init(&r, orientation(1));
        still(&r, 5000);
        r.now += GAPS[i].gap;
        r.attitude = mul(r.attitude, rot_x(-GAPS[i].deg));
        still(&r, 10000);
        CHECK_INT(r.first_cause, YG_MOTION_NONE);
    }
}

static void two_doors_shut_in_a_row_are_ignored(void) {
    /* The first turns fast enough to start the tilt hold, and the second shoves during it. */
    static const float FIRST[] = { 12, 20 };
    static const float SECOND[] = { 0.1f, 0.15f, 0.2f, 0.3f };
    for (size_t a = 0; a < 2; a++) {
        for (size_t b = 0; b < 4; b++) {
            for (uint32_t gap = 200; gap <= 1400; gap += 20) {
                static rig_t r;
                rig_init(&r, identity());
                still(&r, 5000);
                for (uint32_t t = 0; t < 160; t += DT_MS) {
                    float k = expf(-(float)t / 60.0f);
                    const float acc[3] = { 0, 0.2f * k, 0 };
                    const float rot[3] = { FIRST[a] * k * sinf(2 * PI * 5 * (float)t / 1000.0f + 1.57f), 0, 0 };
                    step(&r, acc, rot);
                }
                still(&r, gap);
                shove(&r, SECOND[b]);
                still(&r, 5000);
                CHECK_INT(r.first_cause, YG_MOTION_NONE);
            }
        }
    }
}

static void calibrating_during_a_slow_lean_then_starting_the_engine_is_ignored(void) {
    static const float RATES[] = { 0.2f, 0.3f, 0.5f, 0.7f, 0.9f, 1.1f, 1.5f };
    for (size_t i = 0; i < sizeof(RATES) / sizeof(RATES[0]); i++) {
        static rig_t r;
        rig_init(&r, identity());
        tilt(&r, RATES[i] * 3.5f, 3500, 0);
        engine_on(&r);
        still(&r, 60000);
        CHECK_INT(r.first_cause, YG_MOTION_NONE);
    }
}

static void a_lean_in_the_last_second_of_a_rest_does_not_count_as_rest(void) {
    static const float RATES[] = { 0.5f, 0.8f, 0.95f, 1.02f, 1.05f, 1.1f, 1.2f };
    for (size_t i = 0; i < sizeof(RATES) / sizeof(RATES[0]); i++) {
        for (int k = 0; k < 10; k++) {
            static rig_t r;
            rig_init(&r, identity());
            still(&r, 1500);
            for (int guard = 0; guard < 4000 && !(r.m.rest_windows == 29 && r.m.window_n == 0); guard++) {
                still(&r, DT_MS);
            }
            tilt(&r, RATES[i], 1000, 0);
            reset_seen(&r);
            still(&r, 40000);
            CHECK_INT(r.first_cause, YG_MOTION_NONE);
        }
    }
}

static void a_very_slow_turn_does_not_count_as_rest(void) {
    /* The gyro reads steadily all the way, so only gravity moving gives it away. */
    for (int o = 0; o < ORIENTATIONS; o++) {
        static rig_t r;
        rig_init(&r, orientation(o));
        still(&r, 5000);
        tilt(&r, 60.0f, 40000, o % 2);
        still(&r, 10000);
        CHECK_INT(r.first_cause, YG_MOTION_NONE);
    }
}

static void pulling_out_just_as_a_rest_ends_does_not_count_as_rest(void) {
    /* A creeping turn leaves gravity where it was, so only the gyro gives it away. */
    static rig_t r;
    rig_init(&r, identity());
    still(&r, 1500);
    for (int guard = 0; guard < 4000 && !(r.m.rest_windows == 29 && r.m.window_n == 0); guard++) {
        still(&r, DT_MS);
    }
    const float a[3] = { 0, 0, 0 };
    const float g[3] = { 0, 0, 8.0f };
    for (int i = 0; i < 100; i++) step(&r, a, g);
    CHECK_INT(r.first_cause, YG_MOTION_YAW);
    still(&r, 3000);
    reset_seen(&r);
    still(&r, 20000);
    CHECK_INT(r.first_cause, YG_MOTION_NONE);
}

/* Quiet until this many samples into a second, as nothing else knows when a move starts. */
static void still_until_phase(rig_t *r, uint16_t phase) {
    still(r, 5000);
    for (int guard = 0; guard < 200 && r->m.window_n != phase; guard++) {
        still(r, DT_MS);
    }
}

static void a_move_can_start_at_any_moment(void) {
    static const struct { float deg; uint32_t ms; float offset, scale; } MOVES[] = {
        { 3, 400, 0, 0 }, { 4, 533, 0, 0 }, { 5, 667, 0, 0 }, { 8, 1067, 0, 0 }, { 12, 1600, 0, 0 },
        { 2, 1000, 0, 0 }, { 3, 1500, 0, 0 }, { 4, 2000, 0, 0 },
        { 42, 6000, 0, 0 }, { 45, 1500, 0, 0 }, { 45, 3000, 0.05f, 0.03f },
    };
    for (size_t i = 0; i < sizeof(MOVES) / sizeof(MOVES[0]); i++) {
        for (uint16_t phase = 0; phase < 50; phase++) {
            static rig_t r;
            rig_init(&r, identity());
            r.accel_offset[0] = MOVES[i].offset;
            r.accel_offset[1] = -MOVES[i].offset;
            r.accel_offset[2] = MOVES[i].offset;
            r.gyro_scale = MOVES[i].scale;
            still_until_phase(&r, phase);
            tilt(&r, MOVES[i].deg, MOVES[i].ms, 0);
            still(&r, 15000);
            CHECK_INT(r.first_cause, YG_MOTION_NONE);
        }
    }
}

/* Rocks about where it ends up, with the sensor and the gyro agreeing. */
static void rock(rig_t *r, float amplitude, float hz, float decay_s, float final_deg) {
    mat3 base = r->attitude;
    float previous = 0;
    const float a[3] = { 0, 0, 0 };
    for (uint32_t t = DT_MS; (float)t < decay_s * 5000.0f; t += DT_MS) {
        float s = (float)t / 1000.0f;
        float settle = final_deg * (s < 0.5f ? s / 0.5f : 1.0f);
        float angle = settle + amplitude * sinf(2 * PI * hz * s) * expf(-s / decay_s);
        const float g[3] = { (angle - previous) / 0.02f, 0, 0 };
        previous = angle;
        r->attitude = mul(base, rot_x(-angle));
        step(r, a, g);
    }
}

static void a_body_that_rocks_is_ignored(void) {
    static const struct { float amplitude, hz, decay_s, final_deg; } ROCKS[] = {
        { 0.5f, 1.2f, 2, 0 }, { 2, 1.2f, 2, 0 }, { 5, 1.2f, 2, 0 }, { 5, 2.5f, 2, 0 }, { 0.5f, 1.5f, 1, 5 }, { 1, 1.5f, 1, 4 },
    };
    for (size_t i = 0; i < sizeof(ROCKS) / sizeof(ROCKS[0]); i++) {
        for (uint16_t phase = 0; phase < 50; phase += 7) {
            static rig_t r;
            rig_init(&r, identity());
            still_until_phase(&r, phase);
            rock(&r, ROCKS[i].amplitude, ROCKS[i].hz, ROCKS[i].decay_s, ROCKS[i].final_deg);
            still(&r, 15000);
            CHECK_INT(r.first_cause, YG_MOTION_NONE);
        }
    }
}

static void a_shove_does_not_cut_a_hold_short(void) {
    static rig_t r;
    rig_init(&r, identity());
    still(&r, 5000);
    /* Turning fast enough to start the hold, then a hard shove soon after. */
    const float none[3] = { 0, 0, 0 };
    const float fast[3] = { 12.0f, 0, 0 };
    for (int i = 0; i < 2; i++) step(&r, none, fast);
    const float hard[3] = { 0.2f, 0, 0 };
    for (int i = 0; i < 5; i++) step(&r, hard, none);
    still(&r, 600);
    CHECK(r.out.tilting);
    still(&r, 3000);
    CHECK(!r.out.tilting);
    CHECK_INT(r.first_cause, YG_MOTION_NONE);
}

static void a_pull_out_is_found_when_most_reads_are_lost(void) {
    /* A hold after every gap would never let the acceleration check run. */
    static const struct { int good, lost; } BUSES[] = { { 1, 5 }, { 1, 9 }, { 25, 6 }, { 40, 10 }, { 25, 25 } };
    for (size_t i = 0; i < sizeof(BUSES) / sizeof(BUSES[0]); i++) {
        static rig_t r;
        rig_init(&r, identity());
        still(&r, 5000);
        const float a[3] = { 0.15f, 0, 0 };
        const float g[3] = { 0, 0, 0 };
        for (int n = 0; n < 250; n++) {
            if (n % (BUSES[i].good + BUSES[i].lost) < BUSES[i].good) {
                step(&r, a, g);
            } else {
                r.now += DT_MS;
            }
        }
        CHECK_INT(r.first_cause, YG_MOTION_ACCEL);
    }
}

static void leaving_soon_after_power_on_with_the_engine_running_is_found(void) {
    /* No quiet second, but the averages have agreed before the car moves. */
    static const uint32_t TIMES[] = { 5000, 6000, 7000, 8000, 9000 };
    for (size_t i = 0; i < sizeof(TIMES) / sizeof(TIMES[0]); i++) {
        static rig_t r;
        rig_init(&r, orientation(1));
        engine_on(&r);
        still(&r, TIMES[i]);
        CHECK_INT(r.first_cause, YG_MOTION_NONE);
        const float a[3] = { 0.15f, 0, 0 };
        const float g[3] = { 0, 0, 20.0f };
        uint32_t start = r.now;
        for (int n = 0; n < 150; n++) step(&r, a, g);
        CHECK(r.first_cause != YG_MOTION_NONE);
        CHECK(r.first_cause_at - start <= 1500);
    }
}

static void a_slowly_rising_pull_out_is_found(void) {
    static const struct { float g, ramp_s, within_s; } PULLS[] = {
        { 0.06f, 2, 3.5f }, { 0.08f, 2, 3 }, { 0.1f, 3, 3.5f }, { 0.1f, 5, 5 }, { 0.15f, 8, 6 },
    };
    for (size_t i = 0; i < sizeof(PULLS) / sizeof(PULLS[0]); i++) {
        static rig_t r;
        rig_init(&r, identity());
        still(&r, 5000);
        uint32_t start = r.now;
        const float g[3] = { 0, 0, 0 };
        for (uint32_t t = 0; (float)t < (PULLS[i].ramp_s + 2) * 1000.0f; t += DT_MS) {
            float s = (float)t / 1000.0f;
            const float a[3] = { PULLS[i].g * (s < PULLS[i].ramp_s ? s / PULLS[i].ramp_s : 1.0f), 0, 0 };
            step(&r, a, g);
        }
        CHECK_INT(r.first_cause, YG_MOTION_ACCEL);
        CHECK((float)(r.first_cause_at - start) <= PULLS[i].within_s * 1000.0f);
    }
}

static void readings_that_are_not_gravity_do_not_calibrate(void) {
    static rig_t r;
    rig_init(&r, identity());
    const yg_imu_sample_t zeros = { 0, 0, 0, 0, 0, 0 };
    for (int i = 0; i < 1500; i++) {
        yg_motion_update(&r.m, &r.s, r.now, &zeros, &r.out);
        r.now += DT_MS;
    }
    CHECK(!r.out.calibrated);
    still(&r, 3100);
    CHECK(r.out.calibrated);
    const float a[3] = { 0, 0, 0 };
    const float g[3] = { 0, 0, 25.0f };
    for (int i = 0; i < 75; i++) step(&r, a, g);
    CHECK_INT(r.first_cause, YG_MOTION_YAW);
}

static void gentle_pull_outs_are_still_found(void) {
    static const struct { float g, noise; } PULLS[] = { { 0.06f, 0.005f }, { 0.06f, 0.01f }, { 0.08f, 0.02f }, { 0.10f, 0.03f } };
    for (size_t i = 0; i < sizeof(PULLS) / sizeof(PULLS[0]); i++) {
        for (int k = 0; k < 20; k++) {
            static rig_t r;
            rig_init(&r, identity());
            still(&r, 5000);
            float w = 2 * PI * 4.0f * 0.02f;
            r.random_alpha = w / (1 + w);
            r.random_a = PULLS[i].noise;
            uint32_t start = r.now;
            const float a[3] = { PULLS[i].g, 0, 0 };
            const float g[3] = { 0, 0, 0 };
            for (int s = 0; s < 150; s++) step(&r, a, g);
            CHECK_INT(r.first_cause, YG_MOTION_ACCEL);
            CHECK(r.first_cause_at - start <= 2000);
        }
    }
}

static void turn_is_still_detected_after_the_glove_box_moved(void) {
    static rig_t r;
    rig_init(&r, identity());
    still(&r, 5000);
    tilt(&r, 45.0f, 1000, 1);
    still(&r, 5000);
    reset_seen(&r);
    const float a[3] = { 0, 0, 0 };
    const float g[3] = { 0, 0, 25.0f };
    for (int i = 0; i < 50; i++) step(&r, a, g);
    CHECK_INT(r.first_cause, YG_MOTION_YAW);
}

static void already_moving_at_boot_detects_later_turns(void) {
    static rig_t r;
    rig_init(&r, orientation(1));
    for (uint32_t t = 0; t < 21000; t += DT_MS) {
        float a[3] = { 0.05f * sinf((float)t / 300.0f), 0.05f * cosf((float)t / 200.0f), 0.02f * sinf((float)t / 50.0f) };
        float g[3] = { 0, 0, 8.0f * sinf((float)t / 900.0f) };
        step(&r, a, g);
    }
    CHECK(r.out.calibrated);
    still(&r, 3000);
    reset_seen(&r);
    const float a[3] = { 0, 0, 0 };
    const float g[3] = { 0, 0, 25.0f };
    for (int i = 0; i < 75; i++) step(&r, a, g);
    CHECK_INT(r.first_cause, YG_MOTION_YAW);
}

static void thresholds_come_from_settings(void) {
    static rig_t r;
    rig_init(&r, identity());
    r.s.motion_yaw_deg = 90;
    r.s.motion_accel_mg = 300;
    still(&r, 5000);
    const float a[3] = { 0.1f, 0, 0 };
    const float g[3] = { 0, 0, 20.0f };
    for (int i = 0; i < 100; i++) step(&r, a, g);
    CHECK_INT(r.first_cause, YG_MOTION_NONE);
    still(&r, 15000);
    r.s.motion_accel_mg = 40;
    r.s.motion_accel_ms = 200;
    reset_seen(&r);
    uint32_t start = r.now;
    const float g0[3] = { 0, 0, 0 };
    for (int i = 0; i < 30; i++) step(&r, a, g0);
    CHECK_INT(r.first_cause, YG_MOTION_ACCEL);
    CHECK(r.first_cause_at - start <= 400);
}

static void peaks_report_strongest_then_clear(void) {
    static rig_t r;
    rig_init(&r, identity());
    still(&r, 5000);
    uint16_t accel, yaw;
    yg_motion_take_peaks(&r.m, &accel, &yaw);
    const float a[3] = { 0.1f, 0, 0 };
    const float g[3] = { 0, 0, 20.0f };
    for (int i = 0; i < 50; i++) step(&r, a, g);
    yg_motion_take_peaks(&r.m, &accel, &yaw);
    CHECK(accel >= 80 && accel <= 120);
    CHECK(yaw >= 18 && yaw <= 22);
    yg_motion_take_peaks(&r.m, &accel, &yaw);
    CHECK_INT(accel, 0);
    CHECK_INT(yaw, 0);
}

int main(void) {
    RUN(still_car_calibrates_fast_and_stays_quiet);
    RUN(no_motion_is_reported_before_calibration);
    RUN(engine_shake_is_ignored_and_calibration_falls_back);
    RUN(pulling_out_reports_acceleration_within_a_second);
    RUN(reversing_is_detected_too);
    RUN(gentle_creep_below_threshold_is_not_acceleration);
    RUN(short_push_below_time_threshold_is_ignored);
    RUN(turning_reports_yaw_within_a_second);
    RUN(slow_rotation_outside_the_window_is_not_a_turn);
    RUN(door_slam_is_a_near_miss_not_motion);
    RUN(passenger_getting_in_is_ignored);
    RUN(opening_the_glove_box_is_ignored);
    RUN(lean_then_door_shut_is_not_motion);
    RUN(slow_glove_box_is_ignored);
    RUN(motion_ends_soon_after_the_car_stops);
    RUN(booting_in_a_steady_bend_heals_once_parked);
    RUN(slow_sensor_drift_is_followed);
    RUN(a_small_shift_of_the_gyro_zero_is_ignored);
    RUN(drift_is_followed_even_with_the_engine_shaking);
    RUN(a_gyro_zero_error_cannot_fake_motion);
    RUN(a_small_gyro_zero_error_fades_without_waiting_for_a_rest);
    RUN(a_long_rest_repairs_the_gyro_with_the_engine_running);
    RUN(a_long_rest_works_while_the_zero_drifts);
    RUN(a_start_on_a_moving_car_takes_the_known_gyro_zero);
    RUN(parked_after_a_moving_start_stays_quiet_with_a_known_zero);
    RUN(a_moving_start_reports_the_known_zero_without_saving_it);
    RUN(a_moving_start_with_nothing_known_is_not_worth_keeping);
    RUN(a_rest_after_a_moving_start_is_kept);
    RUN(the_first_steady_start_is_kept_and_reported_once);
    RUN(a_steady_start_measures_the_zero_and_leaves_the_known_one_saved);
    RUN(a_long_rest_keeps_a_zero_that_has_moved);
    RUN(a_long_rest_with_the_same_zero_saves_nothing);
    RUN(a_steady_bend_does_not_replace_a_saved_zero);
    RUN(a_steady_start_replaces_a_saved_zero_that_is_off_on_a_level_axis);
    RUN(a_saved_zero_that_the_start_disagrees_with_is_not_used);
    RUN(a_pull_out_is_still_seen_after_a_wrong_saved_zero);
    RUN(an_impossible_saved_zero_is_ignored);
    RUN(a_saved_zero_that_is_not_a_number_does_not_stay_for_ever);
    RUN(an_impossible_zero_is_never_saved);
    RUN(a_rest_saves_only_a_zero_that_moved_by_half_a_degree);
    RUN(a_saved_zero_is_not_saved_again_at_the_next_rest);
    RUN(warming_up_stays_quiet);
    RUN(random_shake_while_parked_stays_quiet);
    RUN(heavier_shake_fires_no_more_often_than_measured);
    RUN(a_pull_out_is_seen_through_a_real_cars_shake);
    RUN(a_passenger_gets_in_with_the_engine_on_from_the_start);
    RUN(a_lean_too_slow_for_the_gyro_is_ignored);
    RUN(a_glove_box_with_real_sensor_errors_is_ignored);
    RUN(the_unit_moving_while_samples_were_lost_is_ignored);
    RUN(two_doors_shut_in_a_row_are_ignored);
    RUN(calibrating_during_a_slow_lean_then_starting_the_engine_is_ignored);
    RUN(a_lean_in_the_last_second_of_a_rest_does_not_count_as_rest);
    RUN(a_very_slow_turn_does_not_count_as_rest);
    RUN(pulling_out_just_as_a_rest_ends_does_not_count_as_rest);
    RUN(a_big_gyro_zero_error_is_gone_after_a_rest);
    RUN(a_move_can_start_at_any_moment);
    RUN(a_body_that_rocks_is_ignored);
    RUN(a_shove_does_not_cut_a_hold_short);
    RUN(a_pull_out_is_found_when_most_reads_are_lost);
    RUN(leaving_soon_after_power_on_with_the_engine_running_is_found);
    RUN(a_slowly_rising_pull_out_is_found);
    RUN(readings_that_are_not_gravity_do_not_calibrate);
    RUN(gentle_pull_outs_are_still_found);
    RUN(turn_is_still_detected_after_the_glove_box_moved);
    RUN(already_moving_at_boot_detects_later_turns);
    RUN(thresholds_come_from_settings);
    RUN(peaks_report_strongest_then_clear);
    return TEST_RESULT();
}
