Yogranov/ble-gate-opener/test/host/test_gesture.c

#include "yg_gesture.h"
#include "yg_test.h"

static yg_gesture_detector_t g;
static uint32_t now;
static int seen[YG_GESTURE_FACTORY_RESET + 1];

static void setup(void) {
    yg_gesture_init(&g);
    now = 1000;
    memset(seen, 0, sizeof(seen));
}

static void level(bool pressed, uint32_t ms) {
    for (uint32_t t = 0; t < ms; t += 20) {
        seen[yg_gesture_update(&g, now, pressed)]++;
        now += 20;
    }
}

static void click(void) {
    level(true, 100);
    level(false, 100);
}

static void single_click_fires_after_the_wait(void) {
    setup();
    level(true, 100);
    level(false, 300);
    CHECK_INT(seen[YG_GESTURE_SINGLE], 0);
    level(false, 200);
    CHECK_INT(seen[YG_GESTURE_SINGLE], 1);
    level(false, 2000);
    CHECK_INT(seen[YG_GESTURE_SINGLE], 1);
}

static void double_click(void) {
    setup();
    click();
    click();
    level(false, 500);
    CHECK_INT(seen[YG_GESTURE_DOUBLE], 1);
    CHECK_INT(seen[YG_GESTURE_SINGLE], 0);
}

static void triple_click(void) {
    setup();
    click();
    click();
    click();
    level(false, 500);
    CHECK_INT(seen[YG_GESTURE_TRIPLE], 1);
    CHECK_INT(seen[YG_GESTURE_DOUBLE], 0);
    CHECK_INT(seen[YG_GESTURE_SINGLE], 0);
}

static void double_click_then_hold_learns(void) {
    setup();
    click();
    click();
    /* Hold the third press. Beacon pairing at 3 s must not fire; learn fires at 6 s. */
    level(true, 3000);
    CHECK_INT(seen[YG_GESTURE_HOLD], 0);
    CHECK_INT(seen[YG_GESTURE_LEARN], 0);
    level(true, 3200);
    CHECK_INT(seen[YG_GESTURE_LEARN], 1);
    CHECK_INT(seen[YG_GESTURE_HOLD], 0);
    CHECK_INT(seen[YG_GESTURE_DOUBLE], 0);
}

/* Giving up on the learn hold must not count as a third click and start the hotspot,
 * nor leave two clicks behind to set the set point. After two clicks, anything over
 * a second is the hold, not a click. */
static void giving_up_on_the_learn_hold_does_nothing(void) {
    static const uint32_t HELD_MS[] = {1500, 4000};
    for (unsigned i = 0; i < sizeof(HELD_MS) / sizeof(HELD_MS[0]); i++) {
        setup();
        click();
        click();
        level(true, HELD_MS[i]);
        level(false, 1000);
        CHECK_INT(seen[YG_GESTURE_TRIPLE], 0);
        CHECK_INT(seen[YG_GESTURE_DOUBLE], 0);
        CHECK_INT(seen[YG_GESTURE_LEARN], 0);
        CHECK_INT(seen[YG_GESTURE_HOLD], 0);
        /* And the next gesture starts clean. */
        click();
        level(false, 500);
        CHECK_INT(seen[YG_GESTURE_SINGLE], 1);
    }
    /* A brisk third click is still a triple. */
    setup();
    click();
    click();
    level(true, 300);
    level(false, 500);
    CHECK_INT(seen[YG_GESTURE_TRIPLE], 1);
}

static void hold_fires_once_and_release_adds_no_click(void) {
    setup();
    level(true, 2900);
    CHECK_INT(seen[YG_GESTURE_HOLD], 0);
    level(true, 200);
    CHECK_INT(seen[YG_GESTURE_HOLD], 1);
    level(true, 5000);
    CHECK_INT(seen[YG_GESTURE_HOLD], 1);
    level(false, 1000);
    CHECK_INT(seen[YG_GESTURE_SINGLE], 0);
}

static void holding_15_s_asks_for_a_factory_reset_once(void) {
    setup();
    level(false, 100);
    level(true, 14900);
    CHECK_INT(seen[YG_GESTURE_HOLD], 1);
    CHECK_INT(seen[YG_GESTURE_FACTORY_RESET], 0);
    level(true, 200);
    CHECK_INT(seen[YG_GESTURE_FACTORY_RESET], 1);
    level(true, 30000);
    CHECK_INT(seen[YG_GESTURE_FACTORY_RESET], 1);
    level(false, 1000);
    CHECK_INT(seen[YG_GESTURE_SINGLE], 0);
}

static void letting_go_before_15_s_erases_nothing(void) {
    setup();
    level(false, 100);
    level(true, 14500);
    level(false, 1000);
    level(true, 14500);
    level(false, 1000);
    CHECK_INT(seen[YG_GESTURE_HOLD], 2);
    CHECK_INT(seen[YG_GESTURE_FACTORY_RESET], 0);
}

static void button_down_since_power_on_never_erases(void) {
    /* A stuck button would otherwise wipe the unit at every start. */
    setup();
    level(true, 120000);
    CHECK_INT(seen[YG_GESTURE_HOLD], 1);
    CHECK_INT(seen[YG_GESTURE_FACTORY_RESET], 0);

    /* Once it has been let go, a real hold works. */
    level(false, 100);
    level(true, 15100);
    CHECK_INT(seen[YG_GESTURE_FACTORY_RESET], 1);
}

static void bounce_on_a_stuck_button_is_not_letting_go(void) {
    setup();
    level(true, 1000);
    for (int i = 0; i < 4; i++) {
        seen[yg_gesture_update(&g, now, false)]++;
        now += 10;
        seen[yg_gesture_update(&g, now, true)]++;
        now += 10;
    }
    level(true, 30000);
    CHECK_INT(seen[YG_GESTURE_FACTORY_RESET], 0);
}

static void bounce_is_ignored(void) {
    setup();
    /* 10 ms bounce shorter than the debounce time, sampled faster than usual. */
    for (int i = 0; i < 4; i++) {
        seen[yg_gesture_update(&g, now, true)]++;
        now += 10;
        seen[yg_gesture_update(&g, now, false)]++;
        now += 10;
    }
    level(false, 1000);
    CHECK_INT(seen[YG_GESTURE_SINGLE], 0);

    level(true, 100);
    for (int i = 0; i < 4; i++) {
        seen[yg_gesture_update(&g, now, false)]++;
        now += 10;
        seen[yg_gesture_update(&g, now, true)]++;
        now += 10;
    }
    level(true, 60);
    level(false, 1000);
    CHECK_INT(seen[YG_GESTURE_SINGLE], 1);
}

static void unfitted_button_does_nothing(void) {
    setup();
    level(false, 60000);
    for (int i = 1; i <= YG_GESTURE_FACTORY_RESET; i++) CHECK_INT(seen[i], 0);
}

int main(void) {
    RUN(single_click_fires_after_the_wait);
    RUN(double_click);
    RUN(triple_click);
    RUN(double_click_then_hold_learns);
    RUN(giving_up_on_the_learn_hold_does_nothing);
    RUN(hold_fires_once_and_release_adds_no_click);
    RUN(holding_15_s_asks_for_a_factory_reset_once);
    RUN(letting_go_before_15_s_erases_nothing);
    RUN(button_down_since_power_on_never_erases);
    RUN(bounce_on_a_stuck_button_is_not_letting_go);
    RUN(bounce_is_ignored);
    RUN(unfitted_button_does_nothing);
    return TEST_RESULT();
}
