Yogranov/ble-gate-opener/(commit log)

2026-10-31 Add design spec for the ESP-IDF rewrite
    Covers the move from PlatformIO to ESP-IDF v6.1 on an ESP32-C6, the
    moving + heard trigger with an MPU6050, web control of everything,
    logs and debug flag, firmware updates with rollback, and the rollout
    order. The case gets its own spec later.
2026-10-31 Replace PlatformIO with ESP-IDF skeleton and start the logic layer
    Removes platformio.ini and the Arduino source, adds the ESP-IDF v6.1
    project files, partition table and config for the C6, and adds the
    tested logic for settings, trigger, motion detection, sensor health,
    pairing, button gestures and hotspot rules.
2026-10-31 Add the rest of the logic layer and the engine
    Log records, a power-cut safe flash ring, trace sampling, trip
    summaries, debug captures, and the engine that ties them together.
    Scenario tests cover every situation in the design's behaviour table.
    A replay tool runs recorded data through the same logic on a PC.
2026-10-31 Add the hardware layers, decision task, USB console and HTTP API
    NVS settings, remote output with a hard time limit, LED, buzzer and
    button, the MPU6050 driver, the NimBLE scanner, flash logging, the
    hotspot and every API endpoint, firmware upload with rollback, and a
    bench script that checks the API on a real unit over USB.
2026-10-31 Add the web page, log tools, docs and README
    The page covers status, pairing, every setting, trip logs with charts
    and ratings, firmware upload and debug tools, with no external files.
    Log tools fetch over USB or Wi-Fi, summarise, and replay trips through
    the real logic with changed settings.
    Also fixes reading a trip that spans flash sectors, and saves capture
    adverts as they arrive so a power cut cannot lose them.
2026-10-31 Fix the code review's findings in the firmware and page
    The main risk was how easily a parked car could press.
    - A sensor only counts as failed after 5 s with no good read, so a loose
    wire no longer hands control to the fixed threshold. Nothing about it is
    final any more: the unit keeps looking for a missing sensor, wakes one
    that a power glitch put to sleep, and starts the motion estimate over
    after an outage.
    - A press uses up the motion before it, and so does re-arming because the
    car is still. A parked car stays quiet whatever the settings. After a
    press from the fixed threshold, only the beacon going away re-arms.
    - Gravity turns with the gyro, so a lean or a slow glove box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
2026-10-31 Fix the log tools, add bench and page checks, and update the docs
    - Replay starts from the settings the trip really had, follows setting
    changes and sensor failures, and uses raw captures with the trace around
    them. Adverts per second covers only the seconds the beacon was heard.
    A USB fetch warns if it ends early.
    - New checks: test/bench/log_check.py erases full logs and factory resets
    on them, test/bench/page_check.py tests the page in headless Edge against
    the mock, and test/host/test_logs_tool.py covers the log tool.
    - api_check covers bad requests and the guard header, and ota_check covers
    an abandoned upload.
    - The spec and log format describe the new behaviour. The commit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
2026-10-31 Start each bench check from a known state
    An interrupted soak check left a 20 s hotspot time behind, which survives a
    reflash. That stopped the web server part way through the next run, so the
    factory reset never happened, and logs left full were then too slow to read
    over USB, which failed the checks after it.
    Each check now sets what it depends on, and those that read the logs back
    erase them first. The API check restarts first, so that its trip has a boot
    record, and the log check restarts the hotspot after the long fill.
2026-10-31 Stop gyro errors faking motion, and fix what a second review found
    Turning gravity with the gyro brought in a new way to press while parked: a
    small zero error, with engine shake, built up into false acceleration, and
    nothing repaired it with the engine running.
    - The accelerometer now corrects gravity over 2 s, which keeps a zero error
    under 1 deg/s below the threshold.
    - Once a second, from averages in which shake cancels out, the gyro is checked
    against the accelerometer. If it says the unit tilts but gravity has not
    moved, the gyro is wrong: half the error goes, and gravity is reset.
    - Rest is judged from those averages too, so it works with the engine on.
    - Calibrating from avera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
2026-10-31 Drop the gyro check, and calibrate from agreeing averages
    A third review found that comparing the gyro with the accelerometer once a
    second took real moves for gyro errors. A lean starting late in a second could
    press while parked. That check had now caused two rounds of trouble, and the
    design holds up without it, so it is gone rather than patched.
    - Gravity correction is 3 s, which finds a slowly rising pull-out sooner and
    still keeps datasheet offset and scale errors under the threshold.
    - The drift follower covers the whole gyro, vertical included, and a long rest
    repairs the rest. The gyro zero may drift during a rest.
    - Calibration takes two whole-second averages in a row that agr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
2026-10-31 Read an external button on GPIO7, alongside BOOT
    A panel button can't share GPIO9, because holding it at power-on stops the
    unit starting. Also tighten the gate resistor advice to 10 kOhm.
2026-10-31 Add a hardware folder with the board layout and part details
    The layout follows the owner's MuseLab C6, which differs from the DevKitC-1
    in size and pin order, so the docs now give matrix board holes instead of
    header numbers. check_layout.py tests the wiring and fit without a board.
2026-10-31 Record every part size, and mark which ones are assumed
    The sizes behind the stack height were only in the drawing's code, and a case
    also needs the USB plug, corner holes and button. The button's panel hole was
    wrong too: 16 mm looks like its widest part, and its thread looks closer to 12.
2026-10-31 Add a snap-together printed case, and move the button onto the board
    The case is two PETG parts with no screws. Six hidden hooks close it, and the
    board is clamped between legs on the cover and posts in the top, so the remote
    carries no load. A panel button needed 19 mm of extra case and two loose wires,
    so a tactile button now solders to the board, pressed by a flexible tab in the
    top. build_case.py rebuilds the model and print files, and checks the fit, the
    board's way in and the overhangs.
2026-11-01 Record the built board and first case print, and fix what the print showed
    The board is built and bench-tested over USB, so its parts now carry measured
    sizes, and the layout moves the buzzer and MOSFET. The first print fitted, but
    closed loosely and about 2 mm short, and its post held the button down. So the
    hooks now catch at 30 degrees, the legs clamp the board at all four corners,
    and the post stops short of the button. The case README also says where a
    folded manual goes. The fixed case has not been printed yet.
2026-11-01 Add the atlas, a fold-up technician manual, and rules that keep docs in step
    The atlas holds the whole picture, with a trip panel and a 3D case. The manual
    prints on both sides of one A4 sheet, which is cut to 120 x 132 mm and folded
    to 60 x 33 mm to go inside the case. It has not been tried on real paper yet.
    Nothing generates these files from the firmware, so AGENTS.md lists what has
    to change together, and check_docs.py compares them with the firmware, the
    board and the case. It also fails if the manual stops fitting its paper or the
    case. run_tests.py now runs it.
2026-11-02 Hold the button for 15 s to factory reset, with its own sound
    The owner wants to take a unit to the car, plug it in and start from scratch,
    with no phone. At 15 s it plays five short and one long, turns the LED magenta,
    erases the settings, beacon and logs, and restarts. The next start has no
    beacon, so its one long beep says the reset is done.
    A button down since power-on does not count, or a stuck one would wipe the unit
    at every ignition. The erase runs in the decision task, so nothing can press
    the remote or save a setting before the restart. It waits for the sound to end,
    because flash work holds up the task that turns the buzzer off.
    On the real unit, with the hold faked at the GPIO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
2026-11-02 Fix what the first car day showed: failed starts, gyro zero and lost captures
    The first real day in a car showed starts failing on a car screen's USB port,
    false motion from a gyro zero learned on a moving car, captures overwritten by
    driving, and a USB log download that restarted the unit.
    - Save the gyro zero and use it when the car will not hold still at a start. Level
    checks and sanity limits stop a wrong saved zero from pressing a parked car. Log
    it in a new gyro_zero record. Reset to defaults keeps it, and factory reset does not.
    - Wait 1 s after a brownout before starting the radio, and have the log tool count
    failed starts from the gaps in trip numbers.
    - Trigger motion and ne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
2026-11-06 Name the remote's model: BFT MITTO B RCB02
    The owner read "Type: B RCB" and 12V on its case, and MITTO12v-UP on
    its board. The parts tables said only "BFT remote".
2026-11-06 Firm up the case's snap, shorten the button press, and drop unused openings
    The second print fitted, but its Cover closed a little loosely with the parts
    in, and the button press felt long. The board clamp pushes the Cover back by
    0.1 mm, which used up most of the hooks' 0.15 mm catch.
    - Hooks catch 0.35 mm, with a 1.2 mm tooth, 2 mm arms (1.6 mm at the ends)
    and a rounded root. The remote clips are thicker and grip the remote by
    0.2 mm, so it no longer moves.
    - The tab's post stops 0.5 mm short of the button, down from 1 mm.
    - Open only the USB port in use, the native one marked ESP32C6. The CH343
    port stays inside.
    - Drop the slots in front of the antenna and over the buzzer. The un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
2026-11-06 Lay the MOSFET print up for the next units, and move the sensor and buzzer
    The owner finds the MOSFET clearer print up, with its marking readable.
    Turned over in the same holes, its gate would land on ground, so the gate
    network is rewired for it: the 220 ohm runs down column 11, with a straight
    lead to GPIO10 that stays clear of GPIO8, and the 10k lies along row W, with
    a bare ground offcut along row X. The metal tab is the drain and now faces
    the board, so a strip of tape goes under it, and a meter check catches a
    drain touching anything. The first unit keeps the earlier layout.
    The MPU6050 and buzzer move one column toward the antenna end, which takes
    the buzzer from about 1 mm to 3.5 mm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
2026-11-06 Keep the LED for developers, out of the manual and simple mode
    The LED is on the C6 inside the case, so nobody fitting the unit or driving
    with it sees it. The owner keeps it working, for debugging with the case
    open, and wants it out of what a technician reads.
    - The manual and the page's Help tab drop their colour tables. The back of
    the manual now has the sounds on the left and what to do when something
    goes wrong on the right, and it still prints on two sides that fit the
    case.
    - On the page, the LED switch moves to its own card in Advanced mode, and
    Flash the LED moves there too. Simple mode keeps the set point and the
    buzzer, which now sits in a card called Sound.
    - The atla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
2026-11-06 Design the RF board variant that learns and replays a fixed-code remote
2026-11-06 Plan the RF board variant implementation
2026-11-06 Add yg_rfcode frame-match with tolerance
2026-11-06 Learn a stable OOK frame and reject rolling codes
2026-11-06 Add the RF433 build variant: CC1101 driver, build selection, and code storage
    Not compile-checked: no ESP-IDF in the authoring environment.
2026-11-06 Wire the RF actuator, learn endpoints, and status into app and HTTP
    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
2026-11-06 Add the Gate-remote card and driver-aware page for the RF variant
    Page/mock/page_check written; page_check needs Edge, absent here (teammate env runs it).
2026-11-06 Document the RF variant: schematic, pins, build, and what is unproven
2026-11-06 Make both board variants build with ESP-IDF v6.1
    Register yg_rfcode.c in yg_core, require yg_rf unconditionally (Kconfig-conditional requires are unreliable in the early pass), guard yg_rf.c behind the RF config, and fix an empty-struct initializer. Both MOSFET and RF433 images build clean on esp32c6.
2026-11-06 Let the RF receiver hear: a glitch filter the C6 accepts, and GDO0 released
    The 20 us receive filter is beyond the C6's 8-bit filter (3187 ns at the 80 MHz
    group clock), so rmt_receive refused every start, the error was ignored, and
    learning could never hear a remote. The TX channel also drove GDO0 low from its
    creation, against the CC1101's own data output in RX. The pin is now released
    except during a transmit, and a failed receive start is logged.
    The transmit comment now says what the buffer allows: about half a second of a
    typical fixed code, not all of press_ms. That joins the bench list.
    Checked against the ESP-IDF v6.1 source and built; not yet tried on a CC1101.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
2026-11-06 Make the RF learn flow answer people, and keep it from starting the hotspot
    - A press by hand with no remote learned rattles, instead of playing the press
    sound over nothing. The API and the USB console say no remote is learned.
    - A failed capture rattles once per learn session, not for every burst a busy
    band brings.
    - The learn gesture on the MOSFET build rattles instead of doing nothing.
    - After two clicks, a third press over 1 s is the learn hold. Letting go of it
    early does nothing, where it used to count as a triple-click and start the
    hotspot.
    - A learn timeout shows the rejected LED, as a pair timeout does.
    - Forgetting the RF remote asks first, as forgetting the beacon does.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
2026-11-06 Never learn noise: a floor on the frame length, and glitches earn no cue
    The learner took frames of any length, so three noise spikes more than 3 ms
    apart matched within the 80 us floor and were saved as the gate code, with the
    success sound. Frames shorter than 16 durations (eight bits) are no longer
    candidates, so the real frame behind such spikes is found instead, and a burst
    too short to hold three frames is ignored without spending the session's rattle.
    The engine tests now use 12-bit codes rather than five-edge toys.
2026-11-06 Harden the CC1101 driver: wait out reset and calibration, and free the LED's channel
    - At the 100 Hz tick, pdMS_TO_TICKS(1) is zero, so the configuration went out
    right behind the reset strobe. It now waits 1 ms.
    - A transmit waits for the CC1101 to reach TX before sending, so calibration no
    longer clips the first frame. Listening waits for RX the same way.
    - The TX channel asked for 64 symbols, which on the C6 borrows the second TX
    channel and left the developer LED's led_strip without one. It takes 48.
    - A transmit has a hard limit of the press time plus a second, as the MOSFET has.
    - TEST2..0 take SmartRF Studio's 433.92 MHz values, from the same export as FSCAL.
    - The receive loop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
2026-11-06 Record the ordered CC1101 module: header pins, antenna, crystal to check
    The owner ordered an E07-M1101D-style board: CC1101, 433 MHz option, 3.3 V,
    10 dBm, a 2 x 4 header at 2.54 mm, and a soldered spring antenna. The circuit
    now gives its header pin numbers, leaves GDO2 unconnected, keeps the 17.3 cm
    whip as the fallback, and asks for the crystal to be checked for 26.000, which
    the listing does not state and the register values assume.
